phorton1/Arduino-TE3/docs/_old/readme_old.md

# TE3 - teensyExpression3

This is the third, and hopefully last, major iteration of
the teensyExpression/vGuitar rig design and implementation.

Please see the
[vGuitar System](https://github.com/phorton1/phorton1/blob/master/vGuitar/vGuitar.md)
for information regardind the system as a whole.

From a **software perspective**, this repo contains the source code
for the portion of the system that runs on a *teensy4.1* which handles the
"foot pedal" part of the system, as well as acting as the central coordinator
of communications over serial ports and much of the USB Midi to the iPad.

It inherits the functionality of the previous TeensyExpression pedal AND
the previous teensyPiLooper programs, as well as adding new functionality.

- is a USB Midi Device (Midi Controller)
- handles the buttons, rotaries, and expression pedals
- has a TFT display device (possibly with touch capabilities)
- has an SD card for storing SongMachine (and possibly other) files
- is intimately aware of the Midi Protocols used by the FTP
- *may* include a USB Host Port for the FTP (Fishman Triple Play)
- *may* provide *FTP Spoofing* capabilities

It acts as the central communication hub for handling and routing
Serial Midi, Serial Debugging, and Serial File Management to the
other parts of the system.

- communicates via Serial Midi with the TE3_Audio device
- communicates via Serial Midi with the rPi Looper program
- communicates via USB Midi with the iPad
- communicates via USB or dedicated Serial Port with the console.pm program

From an **electronics perspective**, this repo contains **all** of the
kicad schematics and PCB layouts for the entire system.

From a **3D printing perspective**, this repo contains **all** of the
Fusion 360 designs, STL files, Prusa and Lightburn Projects, and gcode
files for building the foot pedal.

## Implementation Notes

### USBC Hub

I will be using the store bought powered USBC hub, along with two
USBC female breakout boards with their resistors removed.

This gives me a high quality hub that can (a) fit in the box, (b) have
a decent pair of rear-facing USBC female plugs, and (c) work in
any cable orientation.

The tricky connections on the hub (photos needed) are:

- **USBC power input** - created a USBC stub cable with a 6 pin JST
  connector that matches the pins on the USBC breakout boards
  - VBUS == 22ga red
  - GND  == 22ga black
  - CC1  == 24ga blue
  - CC2  == 24ga yellow
- **USBC power and data to iPad** - soldered wires from the
  bottom of the USB hub to a 5 pin JST connnector that matches
  the pins on the USBC breakout board:
  - D-   == 22ga green
  - D+   == 22ga yellow
  - GND  == 24ga black
  - CC1  == 22ga white
  - VBUS == 24ga red
  - connect CC2 to CC1

I am only using higher quality, fine strand, tinned, silicon wires
in the TE3 project.

On the iPad output side, I found that if I merely connect CC1 to
CC2, the USBC cable works in either orientation!

The iPad charges at 15V upto about 2.5A, or 26W or so.
The hub does not seem to get unduly hot.

I have verified that I can take 5V to power the rPi from the USBC
hub by drilling some holes and mounting a 2 pin JST connector or
cable that terminates in a 2 pin JST connector.

I merely have to solve the issue of how I connect the USB2 ports
for TE3, TE3_audio, and the FTP.  I am still trying to figure out
how to retrofit a 4 pin JST connector of some kind for that, but
may have to solder cables to the board cuz of the non-standard
pin layouts.

## Please also see

[**TE3_audio**](https://github.com/phorton1/Arduino-TE3_audio)
The **USB Audio** device that also communicates with the rPi Looper
via I2s.

[**TE3_common**](https://github.com/phorton1/Arduino-libraries/TE3_commo)
Functionality and definitions common to the **TE3** and **TE3_audio** programs.

The [**circle-Looper**](https://github.com/phorton1/circle-prh-apps-Looper)
repo contains the source code for the **rPi Looper** application that runs
on a Raspberry Pi that is interfaced to this device.
