phorton1/Arduino-TE3/docs/images/3dp-back_fastener.jpg

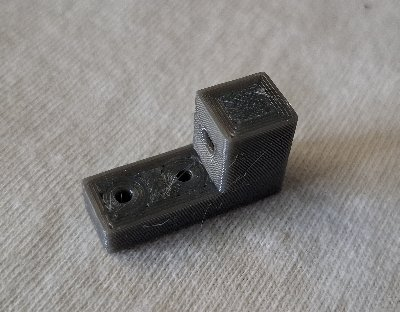
docs/images/3dp-back_fastener.jpg
