phorton1/Arduino-TE3/docs/images/3dp-bezel.jpg

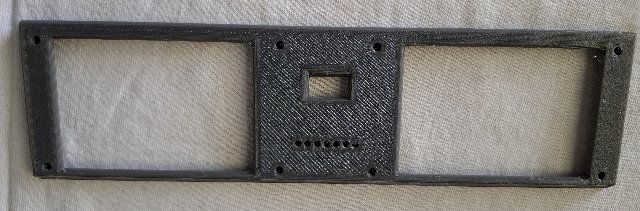
docs/images/3dp-bezel.jpg
