phorton1/Arduino-TE3/docs/images/3dp-button.jpg

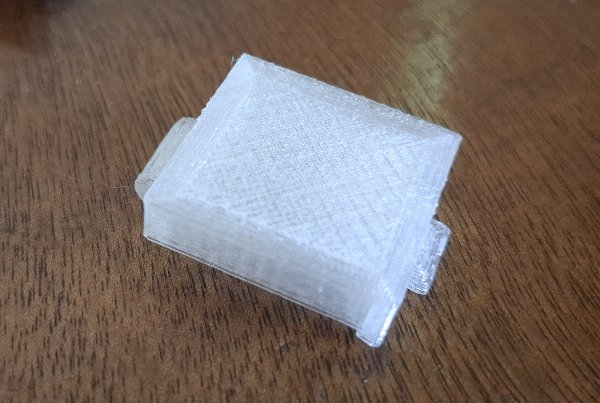
docs/images/3dp-button.jpg
