phorton1/Arduino-TE3/docs/images/3dp-button_bases.jpg

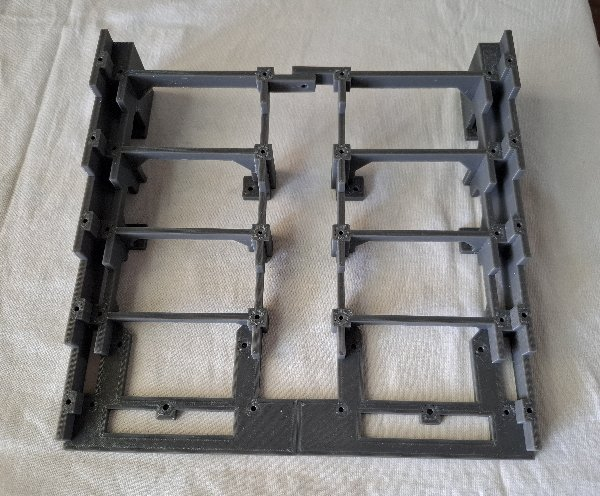
docs/images/3dp-button_bases.jpg
