phorton1/Arduino-TE3/docs/images/3dp-row_base.jpg

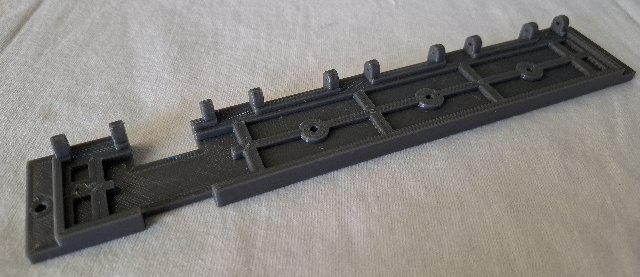
docs/images/3dp-row_base.jpg
