phorton1/Arduino-TE3/docs/images/3dp-slider_bottom.jpg

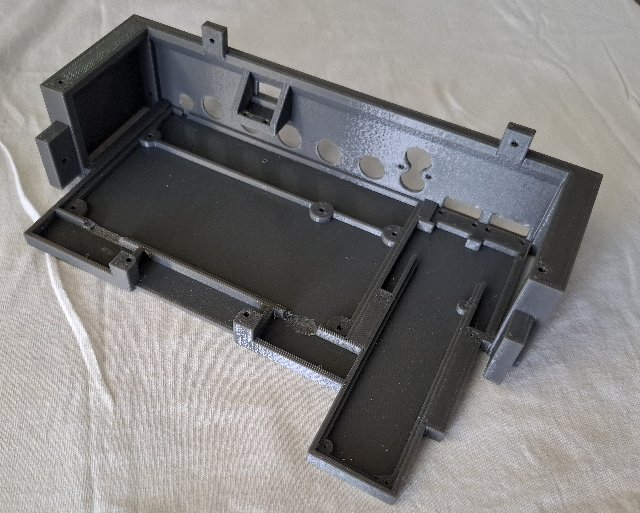
docs/images/3dp-slider_bottom.jpg
