phorton1/Arduino-TE3/docs/images/3dp-slider_top.jpg

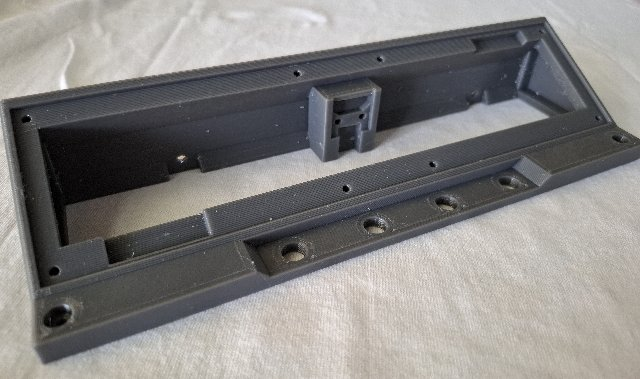
docs/images/3dp-slider_top.jpg
