phorton1/Arduino-TE3/docs/images/3dp-wood_base1_big.jpg

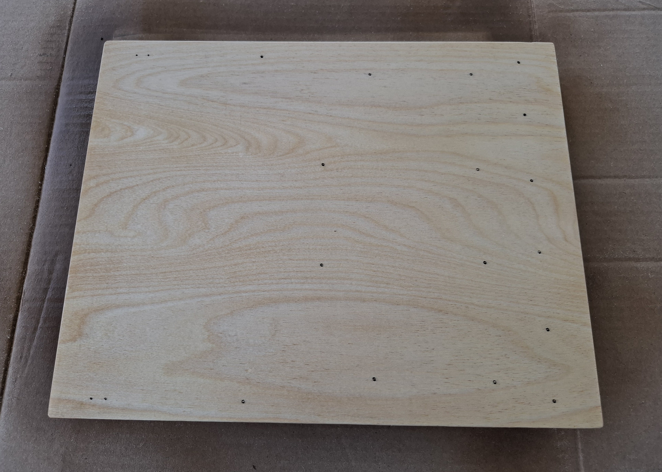
docs/images/3dp-wood_base1_big.jpg
