phorton1/Arduino-TE3/docs/images/home-overview1.jpg

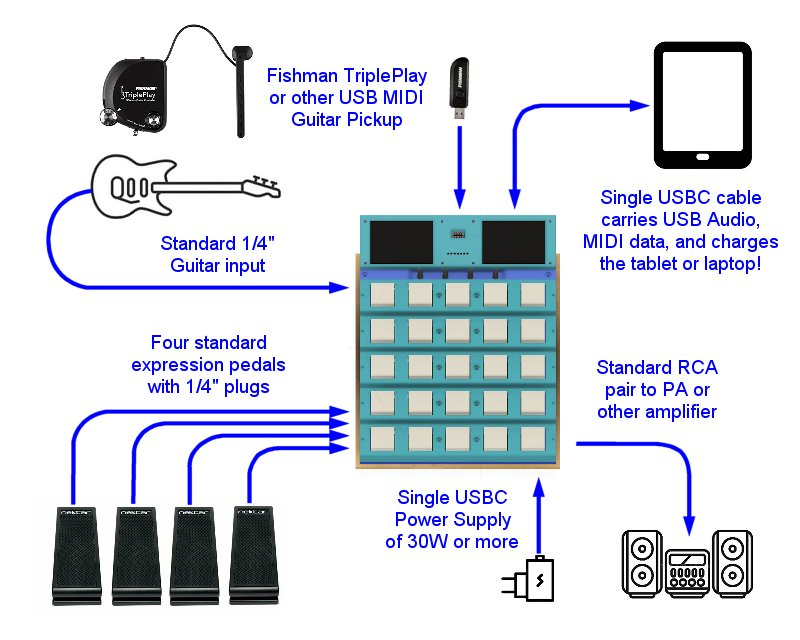
docs/images/home-overview1.jpg
