phorton1/Arduino-TE3/docs/images/pcbs-lcd_connector_front.jpg

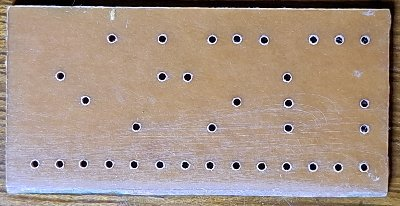
docs/images/pcbs-lcd_connector_front.jpg
