phorton1/Arduino-TE3/docs/images/pcbs-led_board_back_big.jpg

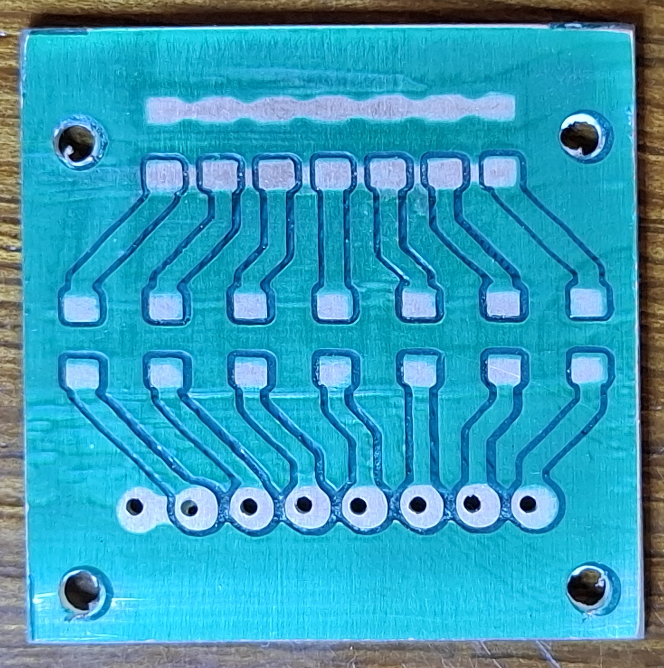
docs/images/pcbs-led_board_back_big.jpg
