phorton1/Arduino-TE3/docs/images/pcbs-led_board_front.jpg

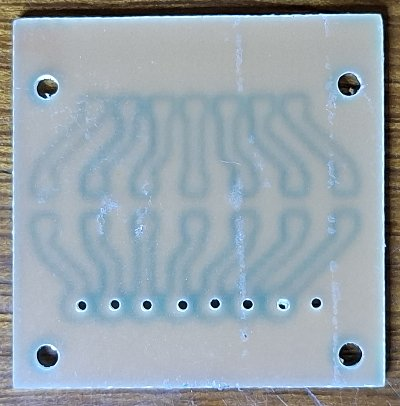
docs/images/pcbs-led_board_front.jpg
