phorton1/Arduino-TE3/docs/images/3dp-all_parts.jpg

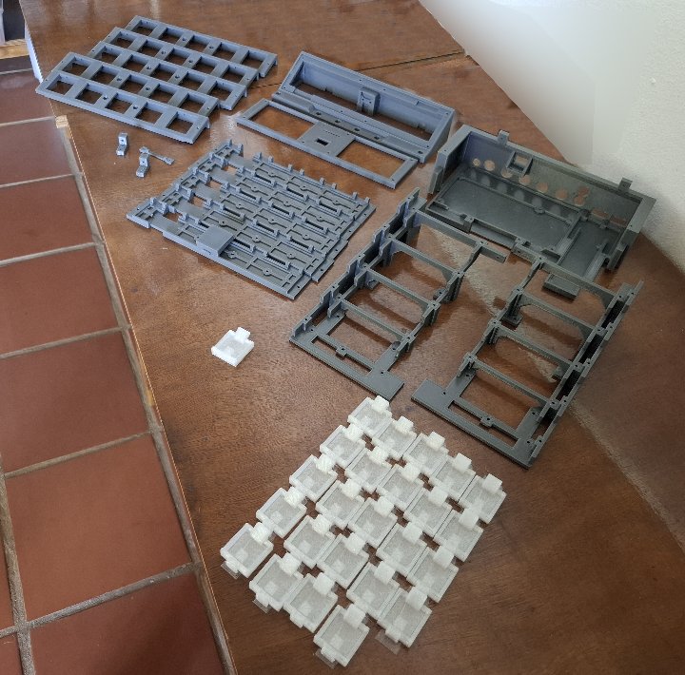
docs/images/3dp-all_parts.jpg
