phorton1/Arduino-TE3/docs/fusion/button_cap.stl

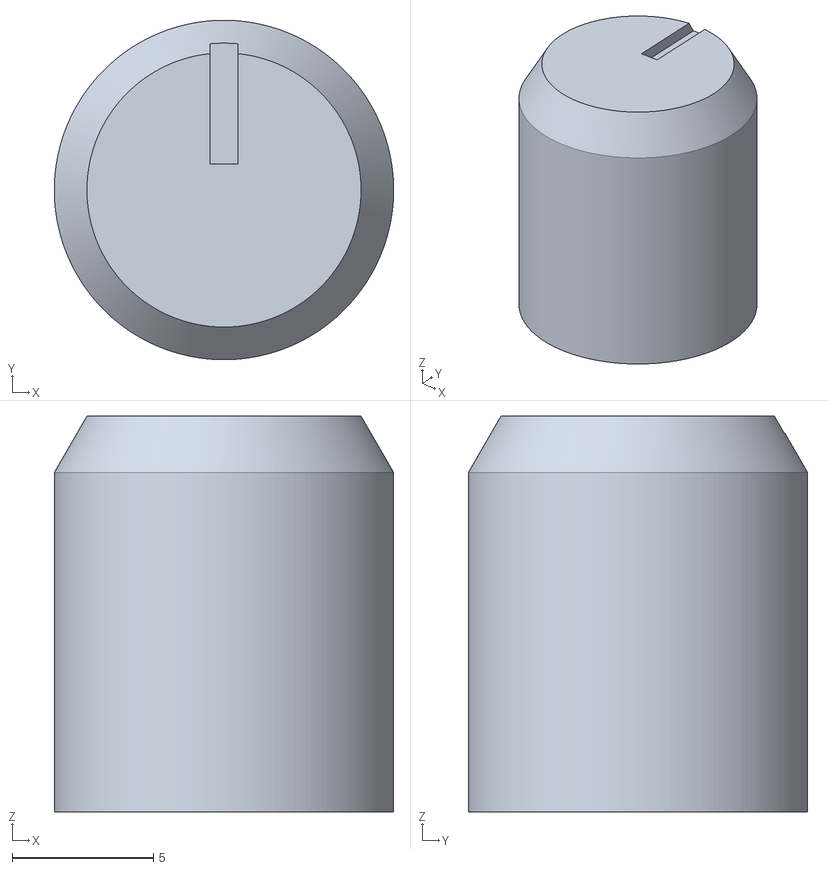
[picture p32: CAD file, 2025-03-22]
docs/fusion/button_cap.stl
12.0 x 12.0 x 14.0
