phorton1/Arduino-TE3/docs/kicad/lcd_connector/lcd_connector.step

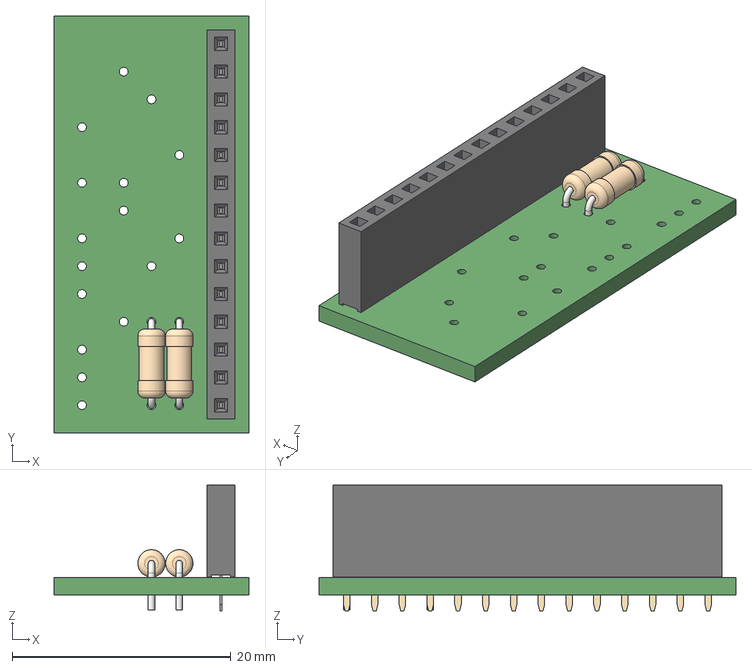
[picture p33: CAD file, 2025-02-02]
docs/kicad/lcd_connector/lcd_connector.step
17.8 x 38.1 x 11.5 mm
