phorton1/Arduino-TE3/docs/kicad/led_board/led_board.step

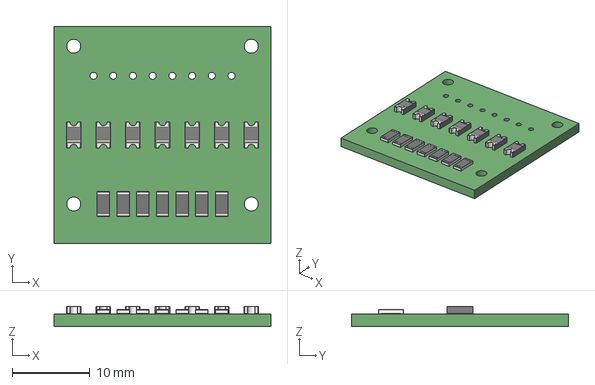
[picture p34: CAD file, 2025-02-14]
docs/kicad/led_board/led_board.step
27.9 x 27.9 x 2.61 mm
