phorton1/Arduino-TE3/docs/kicad/rotary_board/rotary_board.step

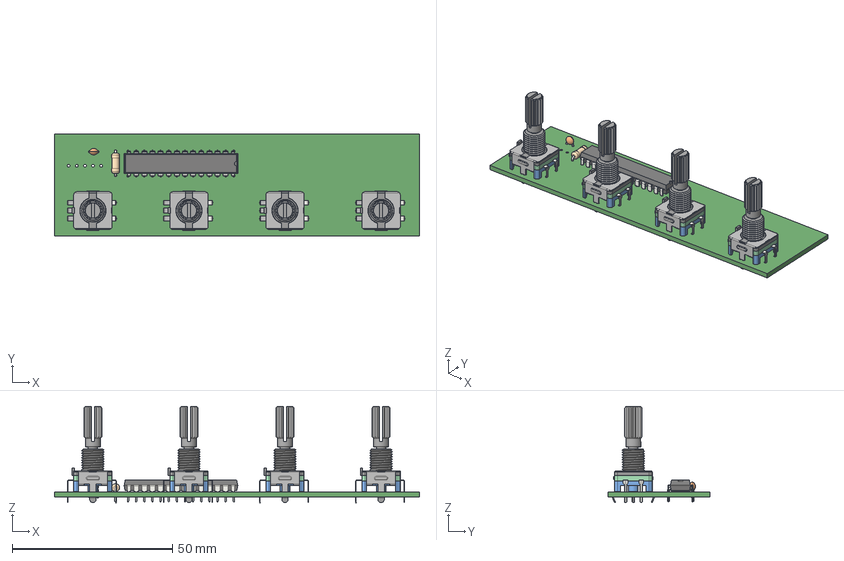
[picture p35: CAD file, 2025-02-27]
docs/kicad/rotary_board/rotary_board.step
114.0 x 32.0 x 30.1 mm
