phorton1/Arduino-TE3/docs/kicad/row_board/row_board.step

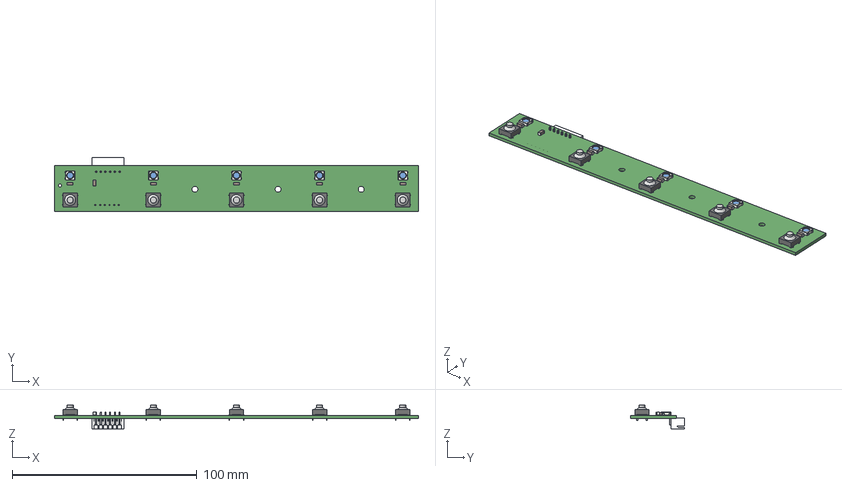
[picture p36: CAD file, 2025-02-11]
docs/kicad/row_board/row_board.step
197.0 x 29.2 x 12.9 mm
