phorton1/Arduino-TE3/docs/kicad/usba_connector/usba_connector.step

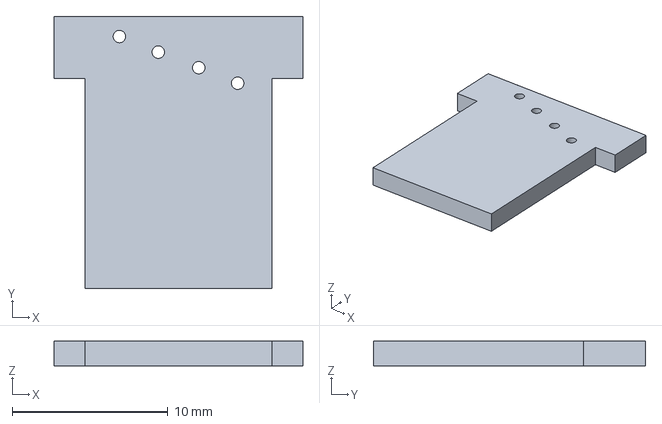
[picture p37: CAD file, 2025-03-05]
docs/kicad/usba_connector/usba_connector.step
16.0 x 17.5 x 1.60 mm
