phorton1/Arduino-TE3/docs/lightburn/laser_cut_base.dxf

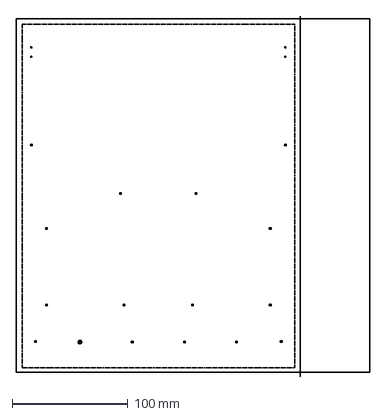
[picture p38: CAD file, 2025-03-06]
docs/lightburn/laser_cut_base.dxf
304.8 x 311.0 mm
