phorton1/Arduino-TE3/docs/prusa/button_cap_x_4.3mf

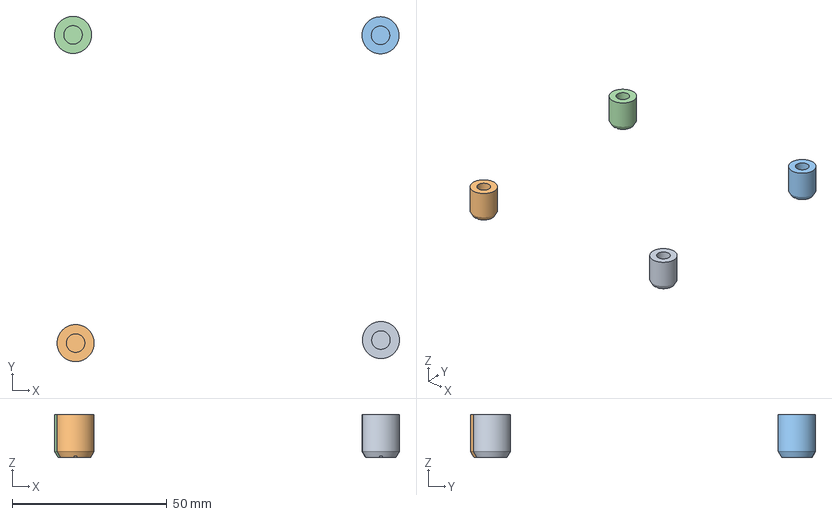
[picture p39: CAD file, 2025-03-22]
docs/prusa/button_cap_x_4.3mf
111.5 x 111.6 x 14.0 mm
button_cap.stl x 4
