phorton1/Arduino-TE3/docs/fusion/slider_bottom.stl

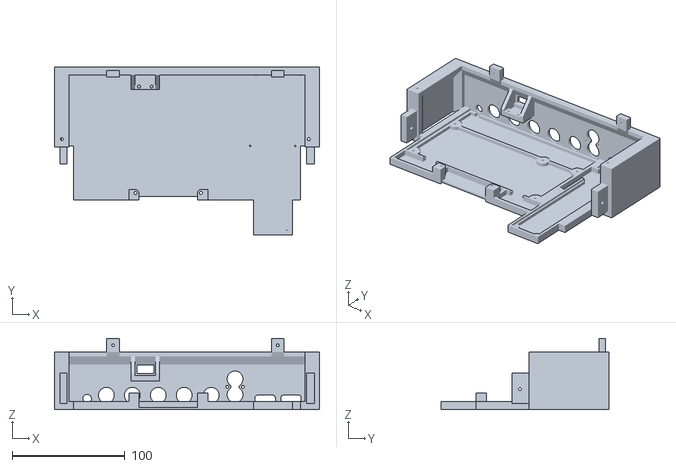
[picture p40: CAD file, 2025-03-07]
docs/fusion/slider_bottom.stl
235.0 x 149.0 x 63.0
