phorton1/Arduino-TE3/docs/fusion/back_fastener.stl

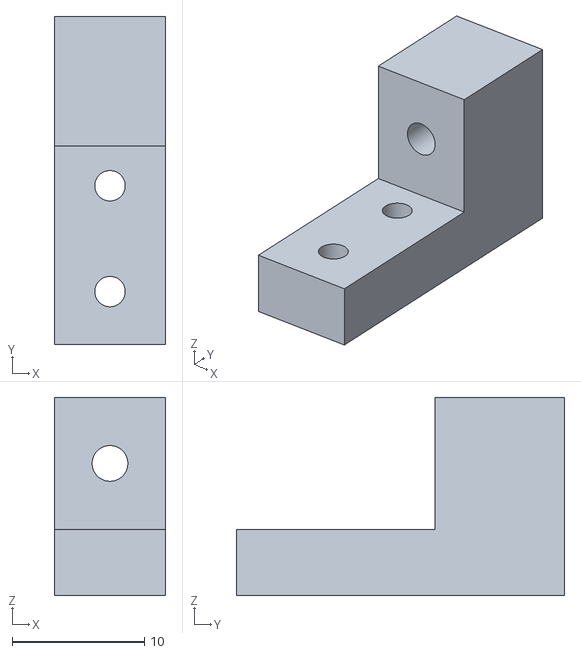
[picture p41: CAD file, 2025-03-07]
docs/fusion/back_fastener.stl
8.40 x 24.8 x 15.0
