phorton1/Arduino-TE3/docs/prusa/back_fasteners.3mf

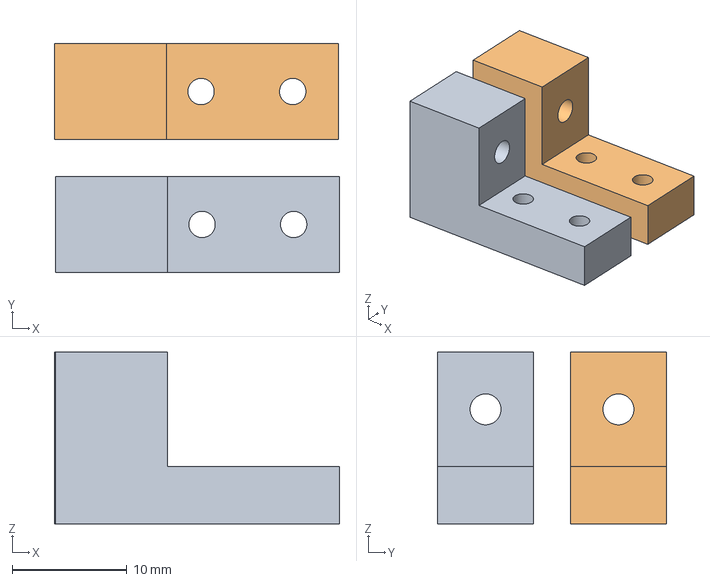
[picture p42: CAD file, 2025-03-07]
docs/prusa/back_fasteners.3mf
24.9 x 20.0 x 15.0 mm
back_fastener.stl x 2
