phorton1/Arduino-TE3/docs/fusion/usb_connector_bottom.stl

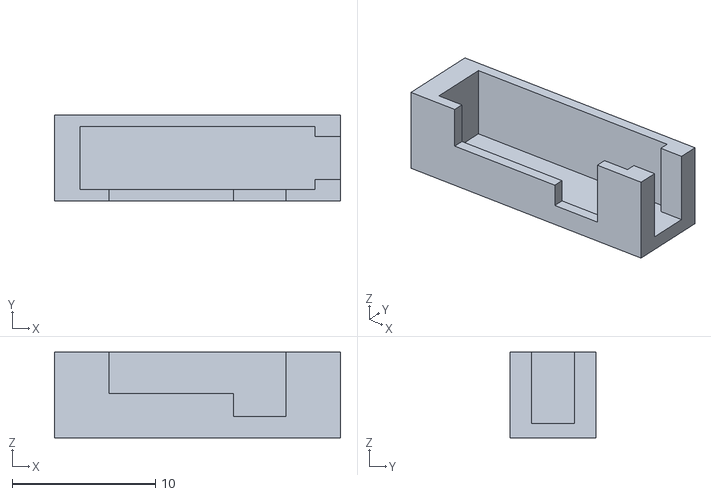
[picture p43: CAD file, 2025-03-05]
docs/fusion/usb_connector_bottom.stl
20.0 x 6.00 x 6.00
