phorton1/Arduino-TE3/docs/prusa/bezel.3mf

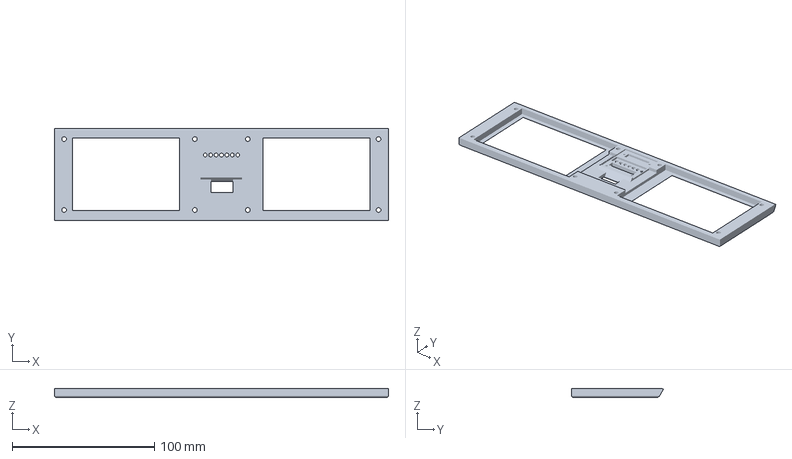
[picture p44: CAD file, 2025-03-05]
docs/prusa/bezel.3mf
235.0 x 64.7 x 6.50 mm
