phorton1/Arduino-TE3/docs/fusion/usb_connector_top.stl

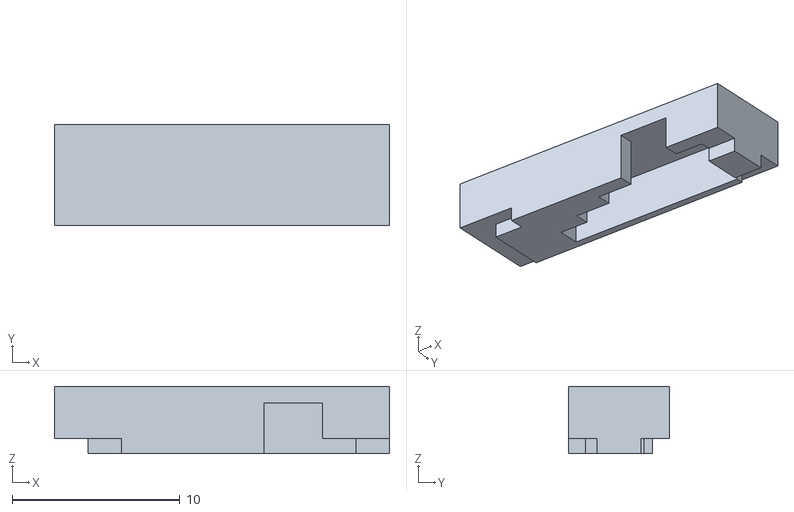
[picture p45: CAD file, 2025-03-05]
docs/fusion/usb_connector_top.stl
20.0 x 6.00 x 4.00
