phorton1/Arduino-TE3/docs/prusa/row_button_x25_PLA.3mf

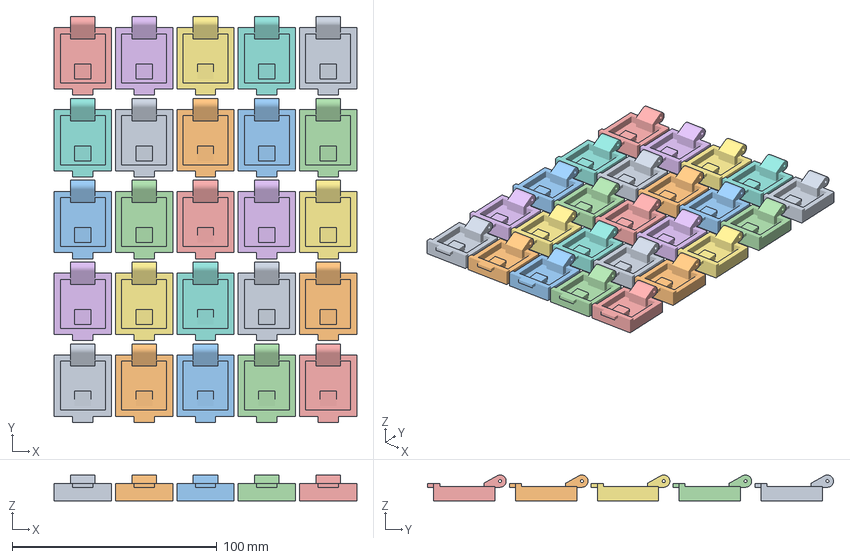
[picture p46: CAD file, 2025-03-05]
docs/prusa/row_button_x25_PLA.3mf
148.0 x 198.5 x 12.7 mm
row_button.stl x 25
