phorton1/Arduino-TE3/docs/fusion/slider_top.stl

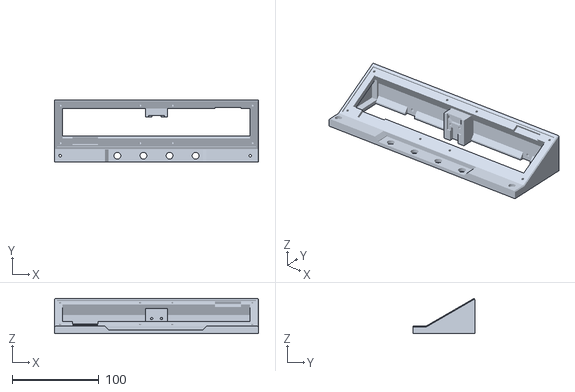
[picture p47: CAD file, 2025-02-27]
docs/fusion/slider_top.stl
235.0 x 71.0 x 40.7
