phorton1/Arduino-TE3/docs/prusa/usb_connector_x3.3mf

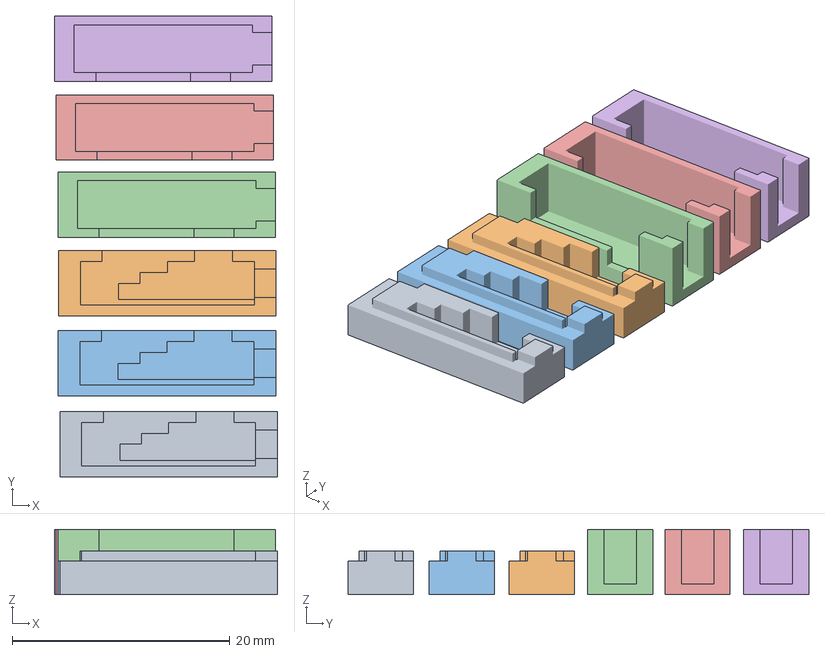
[picture p48: CAD file, 2025-03-05]
docs/prusa/usb_connector_x3.3mf
20.5 x 42.4 x 6.00 mm
usb_connector_top.stl x 3
usb_connector_bottom.stl x 3
