phorton1/Arduino-TE3/docs/fusion/bezel.stl

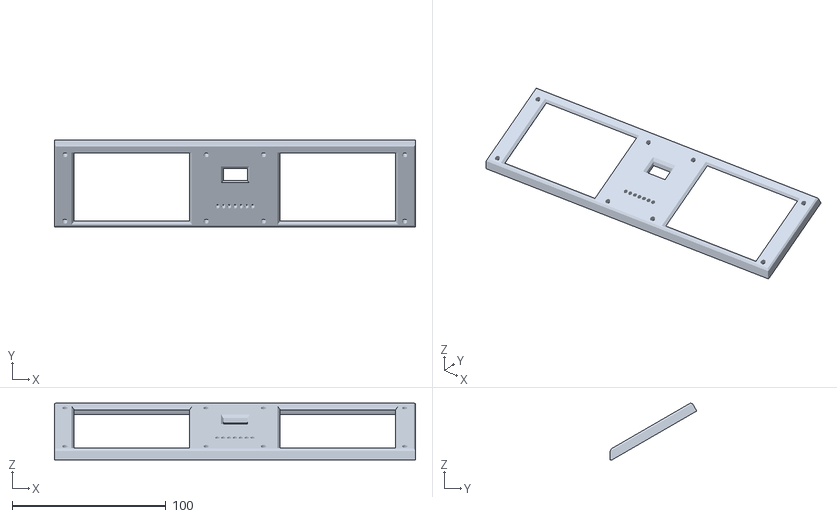
[picture p49: CAD file, 2025-02-27]
docs/fusion/bezel.stl
235.0 x 56.3 x 37.0
