phorton1/Arduino-TE3/docs/fusion/hub_holder.stl

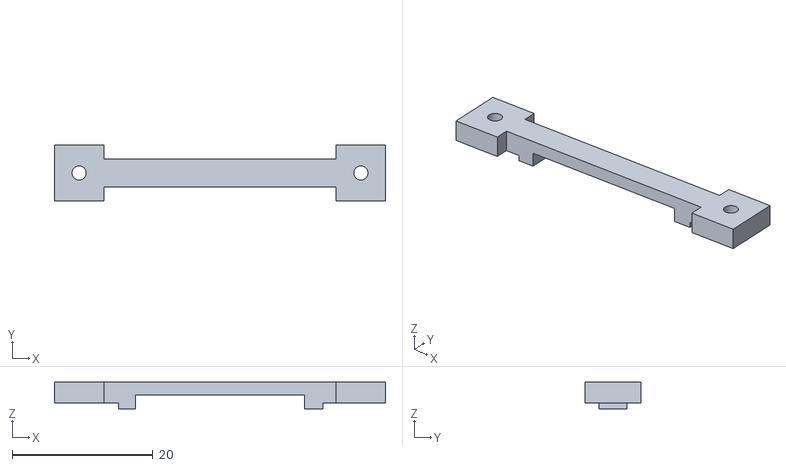
[picture p50: CAD file, 2025-02-27]
docs/fusion/hub_holder.stl
47.0 x 8.00 x 3.80
