phorton1/Arduino-TE3/docs/prusa/button_base_right.3mf

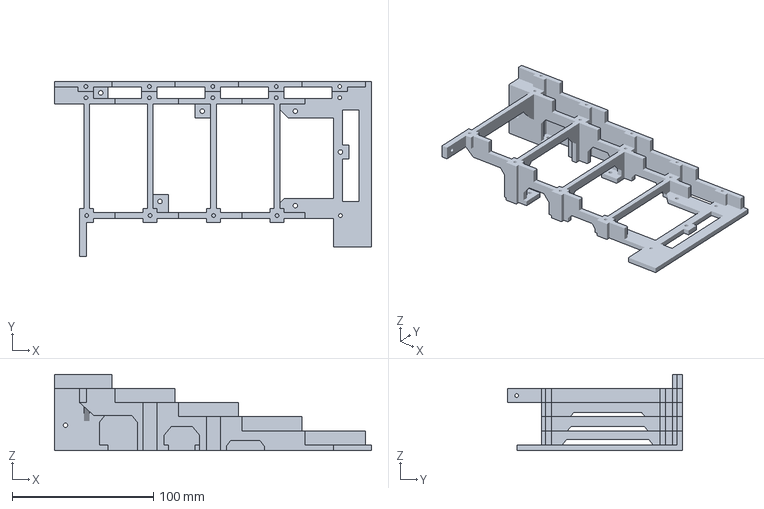
[picture p51: CAD file, 2025-02-25]
docs/prusa/button_base_right.3mf
224.8 x 124.0 x 54.0 mm
