phorton1/Arduino-TE3/docs/fusion/row_base.stl

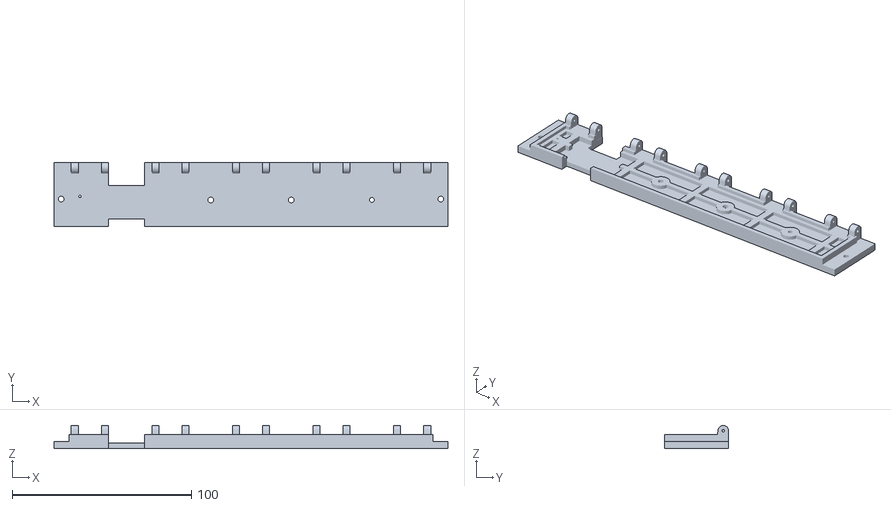
[picture p52: CAD file, 2025-02-25]
docs/fusion/row_base.stl
220.0 x 35.9 x 12.9
