phorton1/Arduino-TE3/docs/prusa/row_base_x4.3mf

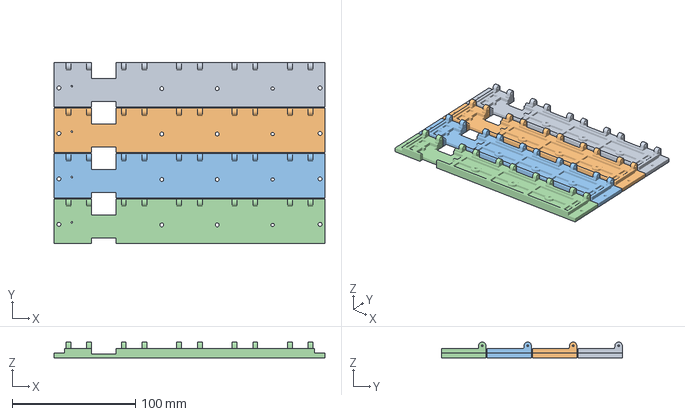
[picture p53: CAD file, 2025-02-25]
docs/prusa/row_base_x4.3mf
220.0 x 146.6 x 12.9 mm
row_base.stl x 4
