phorton1/Arduino-TE3/docs/fusion/row_cover.stl

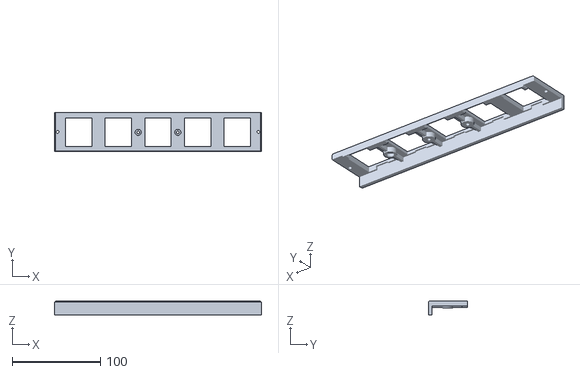
[picture p54: CAD file, 2025-02-25]
docs/fusion/row_cover.stl
235.0 x 44.8 x 15.6
