phorton1/Arduino-TE3/docs/prusa/row_test.3mf

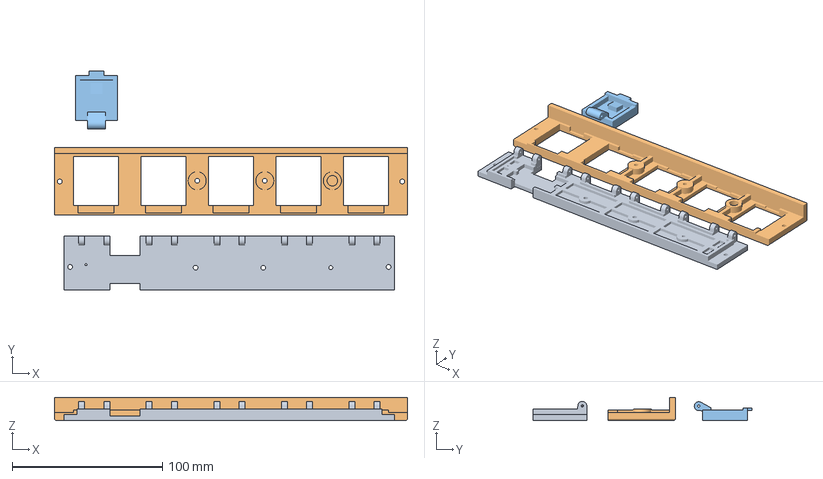
[picture p55: CAD file, 2025-02-25]
docs/prusa/row_test.3mf
235.0 x 145.9 x 15.6 mm
row_base.stl
row_cover.stl
row_button.stl
