phorton1/Arduino-TE3/docs/prusa/row_cover_x4.3mf

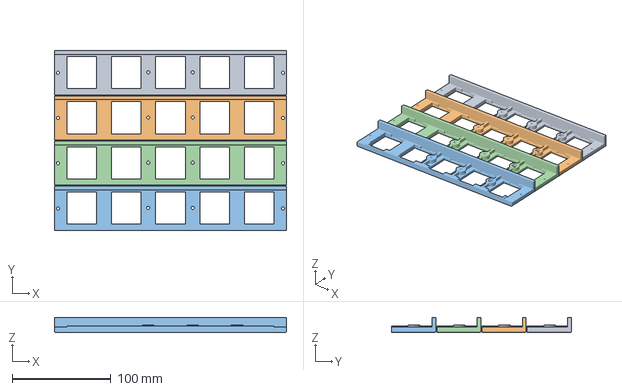
[picture p56: CAD file, 2025-02-25]
docs/prusa/row_cover_x4.3mf
235.0 x 182.2 x 15.6 mm
row_cover.stl x 4
