phorton1/Arduino-TE3/docs/fusion/row_button.stl

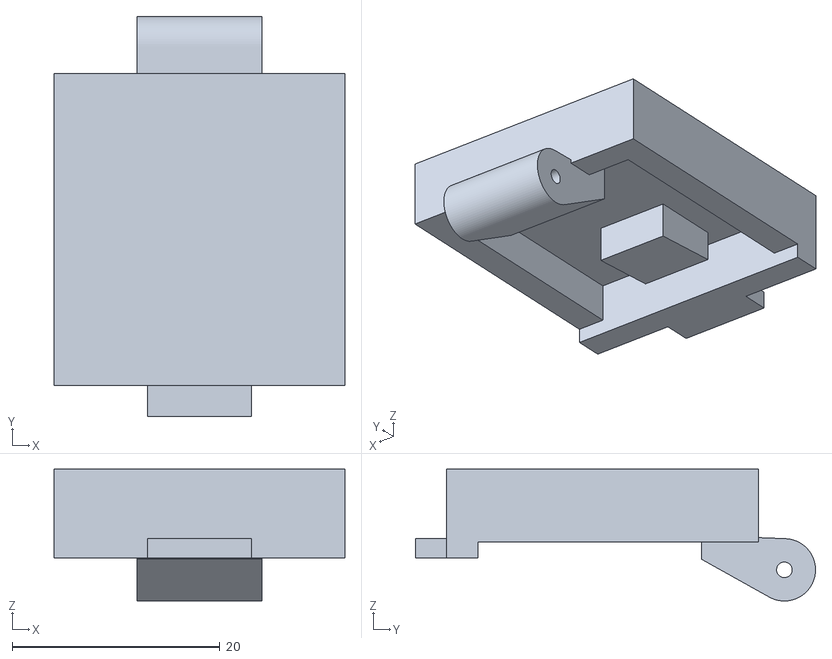
[picture p57: CAD file, 2025-02-25]
docs/fusion/row_button.stl
28.0 x 38.5 x 12.7
