phorton1/Arduino-TE3/(list of files, cad)

Other CAD files:
docs/prusa/slider_bottom.3mf
docs/prusa/slider_top.3mf
docs/fusion/button_base_left.stl
docs/prusa/button_base_left.3mf
docs/fusion/button_base_right.stl
docs/fusion/usba_connector_plastic.f3d
docs/kicad/led_board/plot/led_board-F_Paste.dxf
docs/kicad/row_board/plot/row_board-F_Paste.dxf
