phorton1/Arduino-TE3/docs/fusion/build_anim2/Image01.jpg

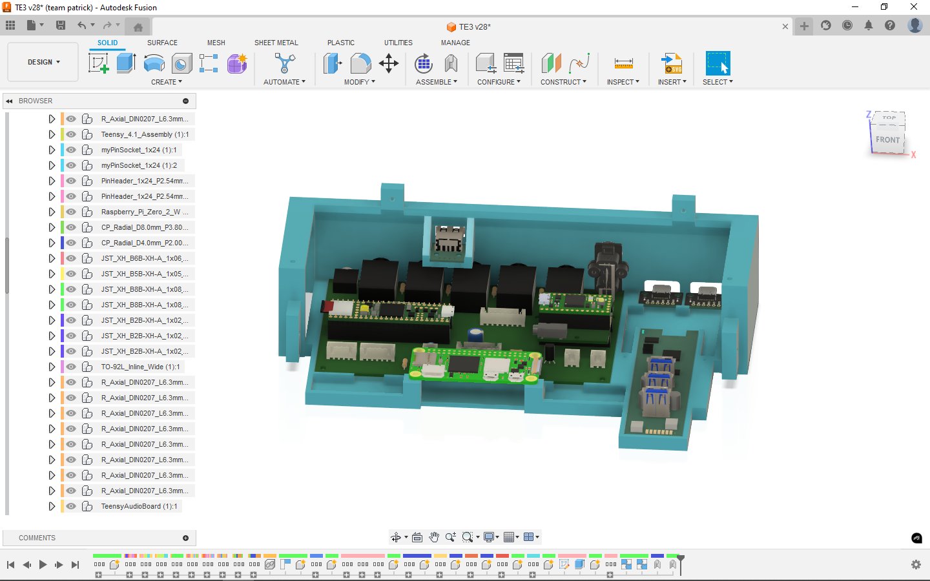
docs/fusion/build_anim2/Image01.jpg
