phorton1/Arduino-TE3/docs/fusion/build_anim2/Image02.jpg

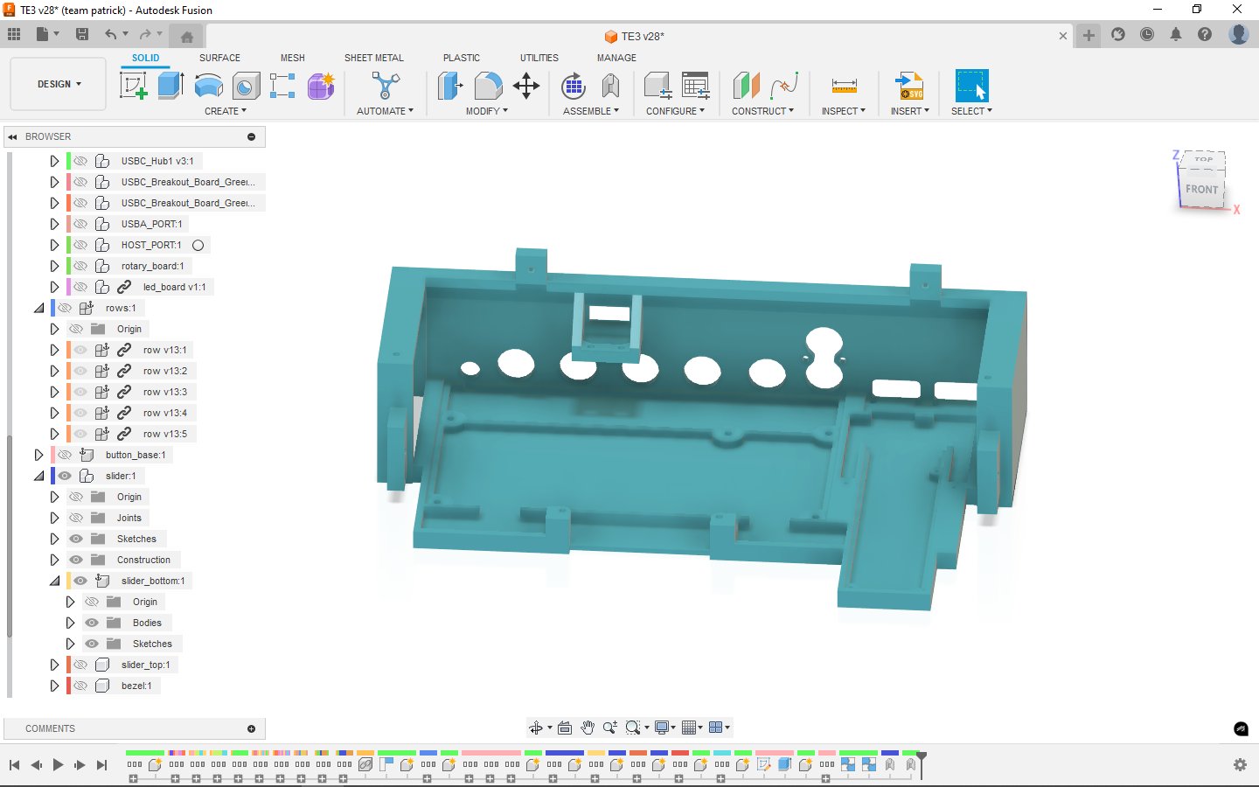
docs/fusion/build_anim2/Image02.jpg
