phorton1/Arduino-TE3/docs/fusion/build_anim3/Image00.jpg

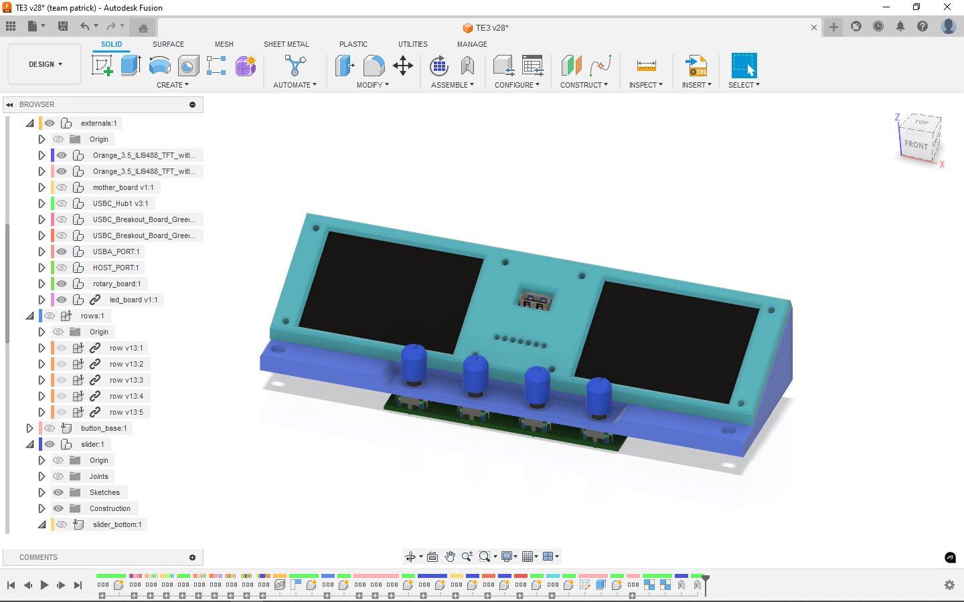
docs/fusion/build_anim3/Image00.jpg
