phorton1/Arduino-TE3/docs/fusion/build_anim3/Image03.jpg

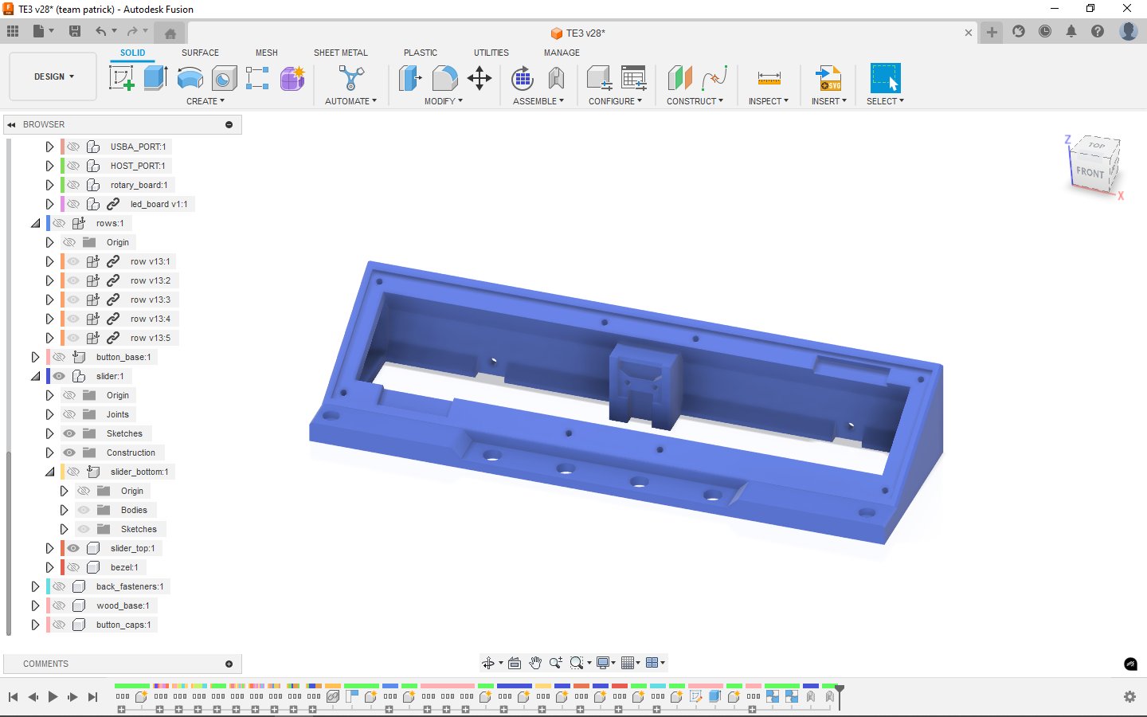
docs/fusion/build_anim3/Image03.jpg
