phorton1/Arduino-TE3/docs/fusion/build_anim4/Image1.jpg

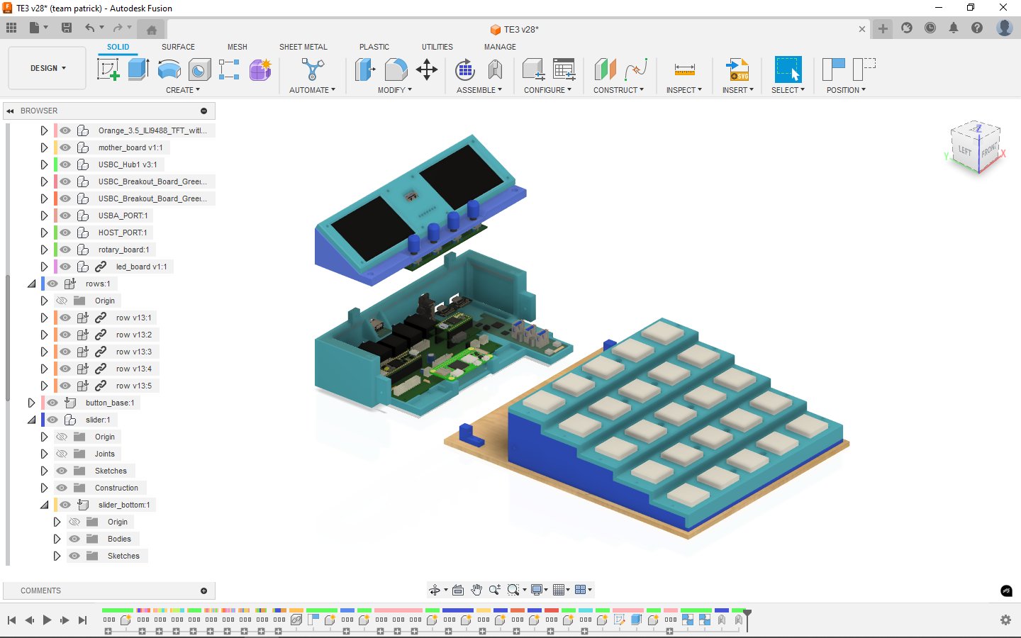
docs/fusion/build_anim4/Image1.jpg
