phorton1/Arduino-TE3/docs/images/build-anim1.gif

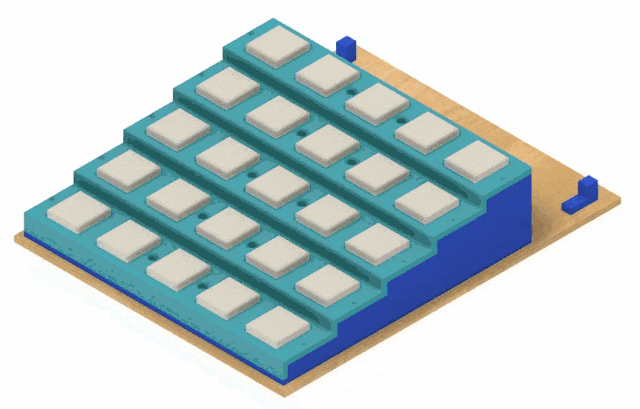
docs/images/build-anim1.gif
