phorton1/Arduino-TE3/docs/images/build-anim2.gif

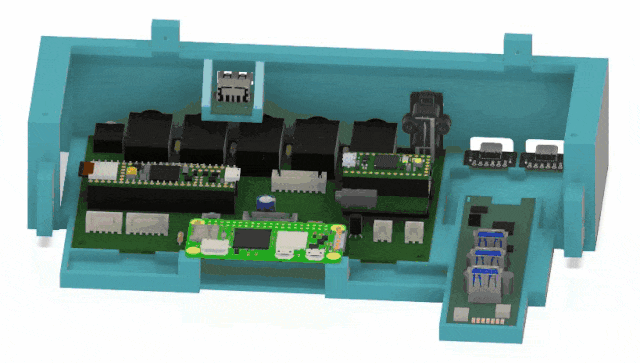
docs/images/build-anim2.gif
