phorton1/Arduino-TE3/docs/images/build-anim3.gif

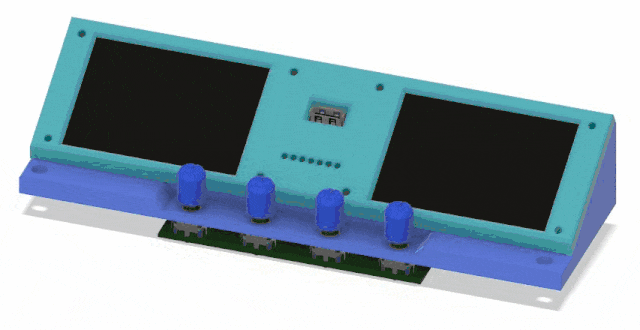
docs/images/build-anim3.gif
