phorton1/Arduino-TE3/docs/images/build-anim4.gif

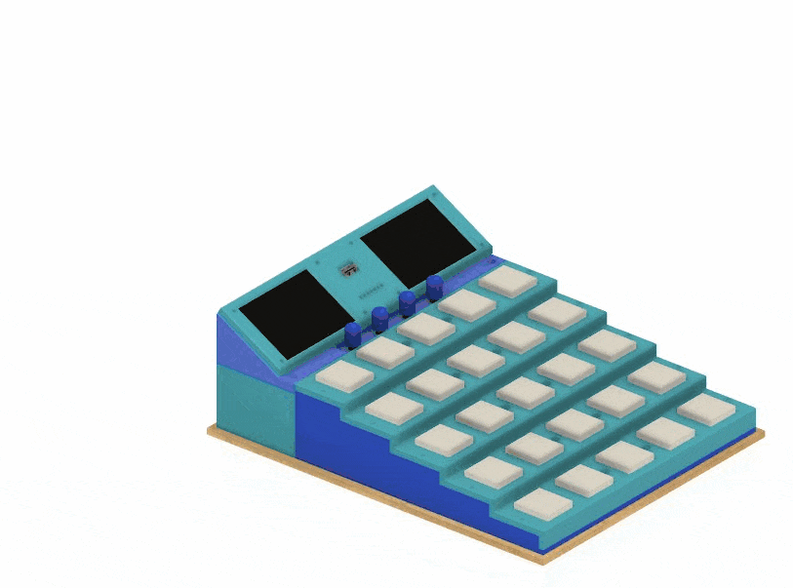
docs/images/build-anim4.gif
