phorton1/Arduino-TE3/docs/images/solder-row_board_cable.jpg

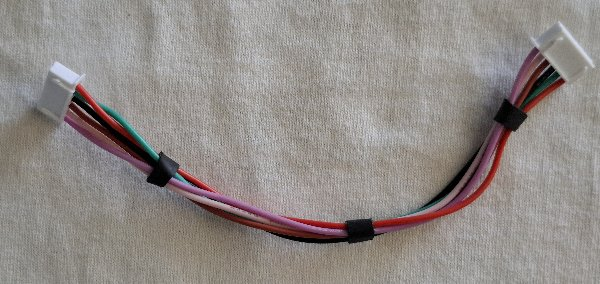
docs/images/solder-row_board_cable.jpg
