phorton1/Arduino-TE3/docs/images/solder-test_setup.jpg

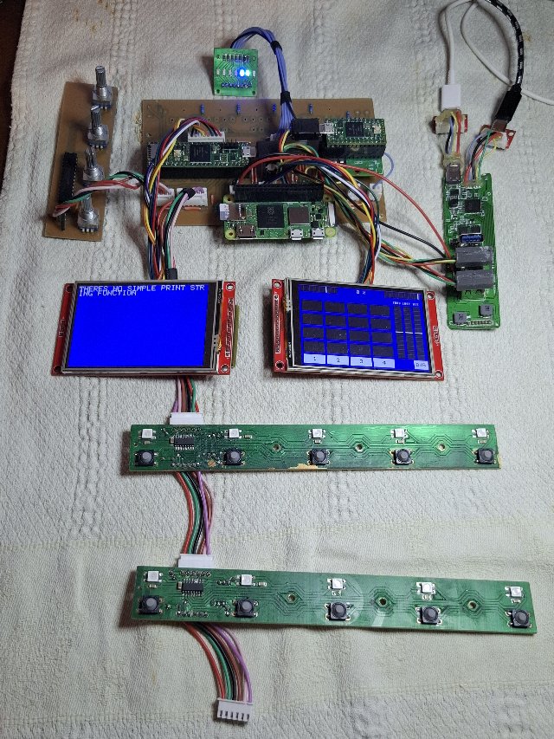
docs/images/solder-test_setup.jpg
