phorton1/Arduino-TE3/docs/kicad/mother_board/mother_board.kicad_pcb

## KiCad design docs/kicad/mother_board/mother_board.kicad_pcb (2025-03-18)

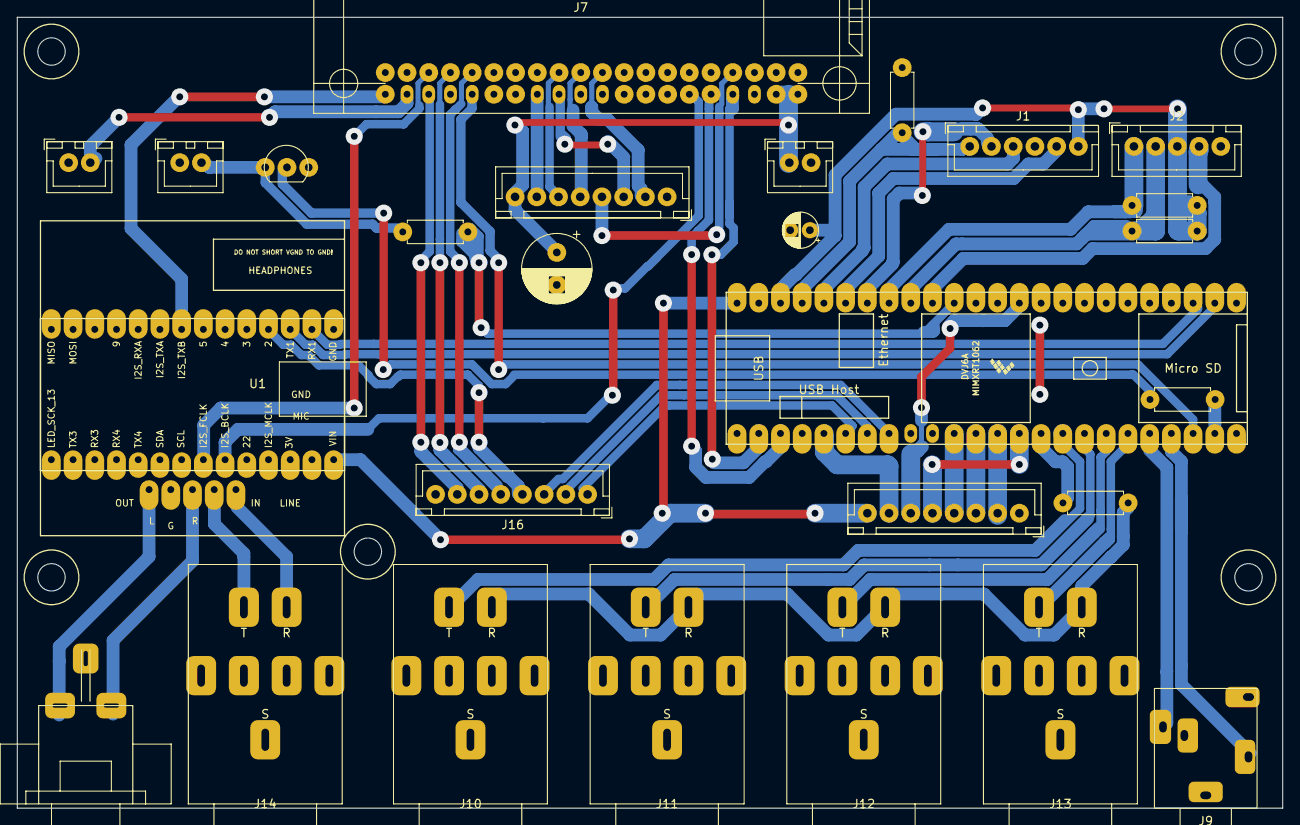
[picture p93: board mother_board.kicad_pcb from above]

Board: 2 copper layers, 148.0 x 92.5 mm, 27 parts (0 on the bottom side), 54 nets.

Parts:
C1: 100uf; CP_my100uf
C2: 47uf; CP_my10uf
J1: ROW_BOARDS; myJSTx06
J2: ROTARIES; myJSTx05
J3: TE_DISPLAY; myJSTx08
J4: RPI_DISPLAY; myJSTx08
J5: rPi_5V; myJSTx02
J6: RPI_RUN; myJSTx02
J7: rpi_connector; rpi_zero_2w_for_TE3
J8: I2S_TXB; myJSTx02
J9: EigthInchJack1
J10: PEDAL1; QuarterInchJack1
J11: PEDAL2; QuarterInchJack1
J12: PEDAL3; QuarterInchJack1
J13: PEDAL4; QuarterInchJack1
J14: GUITAR_IN; QuarterInchJack1
J15: LINE_OUT; RCA2_PCB_milled
J16: LEDS; myJSTx08
Q1: BC547; myTransistor
R1, R2, R4: 1K; myResistor
R3, R5: 220; myResistor
R11: 10K; myResistor
U1: teensyAudioRevD_WithAudio; audioShieldRevD_audioPinsStack
U2: myTeensy4.1; teensy41

Connections:
+5V: J3.8, U1.28, U2.48
BTN_CLK: J1.5, U2.43
BTN_DIN: J1.3, U2.44
BTN_SENSE: J1.1, R11.1, U2.45
GND: C1.2, C2.2, J1.4, J2.5, J3.1, J4.1, J5.2, J6.1, J7.6, J7.9, J7.14, J7.20, J7.25, J7.30, J7.34, J7.39, J8.1, J9.S, J10.S, J11.S, J12.S, J13.S, J14.S, J15.G, J16.8, Q1.3, R11.2, U1.1, U1.27, U1.32, U2.1, U2.34, U2.47
I2S_BCLK: J7.12, U1.23
I2S_FCLK: J7.35, U1.22
I2S_RXB: J7.40, U1.8
I2S_TXB: J7.38, J8.2
LED_AUDIO_BUSY: J16.4, U1.4
LED_DIN: J1.2, U2.42
LED_RPI_BUSY: J7.31, J16.5
LED_RPI_I2S_RX: J7.33, J16.6
LED_RPI_I2S_TX: J7.36, J16.7
LED_RPI_READY: J16.3, U2.8
LED_RPI_RUN: J16.2, U2.7
LED_T3_BUSY: J16.1, U2.6
LINE_IN_L: J14.R, U1.29
LINE_IN_R: J14.T, U1.30
LINE_OUT_L: J15.L, U1.33
LINE_OUT_R: J15.R, U1.31
unnamed: J10.R, J11.R, J12.R, J13.R, R5.2
unnamed: Q1.2, R4.2
PEDAL1: J10.T, U2.16
PEDAL2: J11.T, U2.17
PEDAL3: J12.T, U2.18
PEDAL4: J13.T, U2.19
PI_REBOOT: R4.1, U2.23
ROT_INT: J2.4, U2.39
RPI_5V: C1.1, J4.8, J5.1, J7.2, J7.4
RPI_LCD_CS: J4.3, J7.24
RPI_LCD_DC: J4.4, J7.7
RPI_MISO: J4.5, J7.21
RPI_MOSI: J4.2, J7.19
RPI_READY: J7.32, U2.22
RPI_RUN: J6.2, Q1.1, R3.2
RPI_SCLK: J4.6, J7.23
RPI_T_CS: J4.7, J7.26
SENS_PI_RUN: R3.1, U2.38
T41_3V3: C2.1, J1.6, J2.3, R1.1, R2.1, R5.1, U2.15, U2.46
T41_LCD_CS: J3.3, U2.12
T41_LCD_DC: J3.4, U2.11
T41_MISO: J3.5, U2.14
T41_MOSI: J3.2, U2.13
T41_RX1: J7.8, U2.2
T41_RX7: J9.T, U2.21
T41_RX8: U1.3, U2.26
T41_SCL: J2.1, R1.2, U2.41
T41_SCLK: J3.6, U2.35
T41_SDA: J2.2, R2.2, U2.40
T41_TX1: J7.10, U2.3
T41_TX7: J9.R, U2.20
T41_TX8: U1.2, U2.27
T41_T_CS: J3.7, U2.5
