phorton1/Arduino-TE3/docs/kicad/lcd_connector/lcd_connector.kicad_pcb

## KiCad design docs/kicad/lcd_connector/lcd_connector.kicad_pcb (2025-03-05)

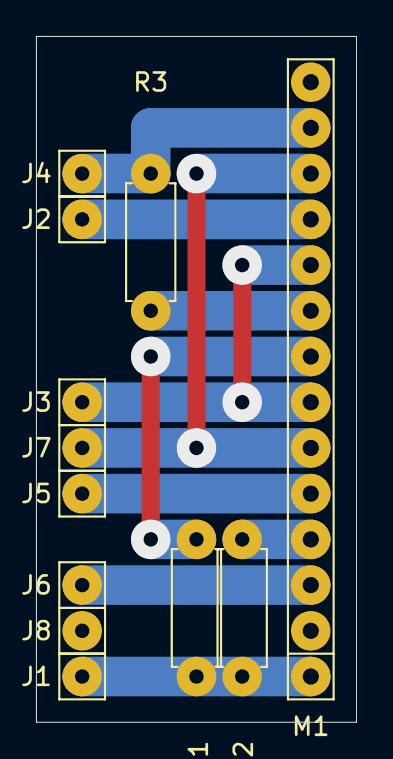
[picture p94: board lcd_connector.kicad_pcb from above]

Board: 2 copper layers, 17.8 x 38.1 mm, 12 parts (0 on the bottom side), 11 nets.

Parts:
J1: 5V; my1pin
J2: T_CS; my1pin
J3: CLK; my1pin
J4: MISO; my1pin
J5: DC; my1pin
J6: CS; my1pin
J7: MOSI; my1pin
J8: GND; my1pin
M1: TFT_ILI9488; myPinSocket_1x14
R1: 100; myResistor
R2: 10K; myResistor
R3: 220; myResistor

Connections:
unnamed: J1.1, M1.1, R1.1, R2.1
unnamed: J2.1, M1.11
unnamed: J3.1, M1.7, M1.10
unnamed: J4.1, M1.13, R3.1
unnamed: J5.1, M1.5
unnamed: J6.1, M1.3
unnamed: J7.1, M1.6, M1.12
unnamed: J8.1, M1.2
unnamed: M1.4, R2.2
unnamed: M1.8, R1.2
unnamed: M1.9, R3.2
