phorton1/Arduino-TE3/docs/kicad/led_board/led_board.kicad_pcb

## KiCad design docs/kicad/led_board/led_board.kicad_pcb (2025-03-05)

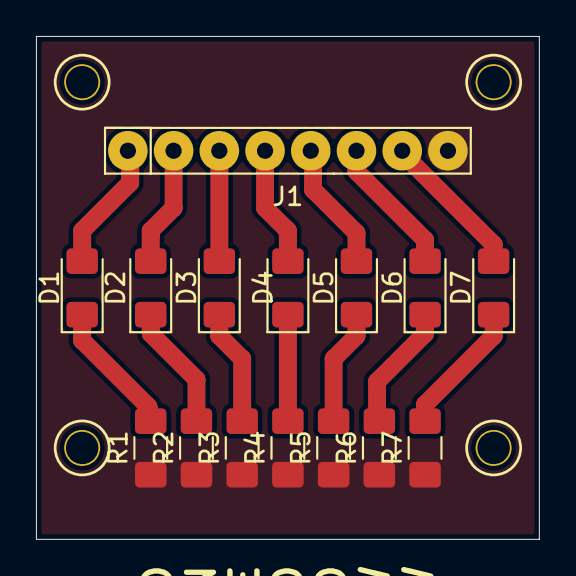
[picture p95: board led_board.kicad_pcb from above]

Board: 2 copper layers, 27.9 x 27.9 mm, 15 parts (0 on the bottom side), 15 nets.

Parts:
D1, D2, D3, D4, D5, D6, D7: LED_Small; D_1206_3216Metric_Pad1.42x1.75mm_HandSolder
J1: Conn_01x08; my8Pin
R1, R2, R3, R4, R5, R6, R7: R_Small; R_1206_3216Metric_Pad1.42x1.75mm_HandSolder

Connections:
GND: J1.8, R1.1, R2.1, R3.1, R4.1, R5.1, R6.1, R7.1
unnamed: D1.1, R1.2
unnamed: D1.2, J1.1
unnamed: D2.1, R2.2
unnamed: D2.2, J1.2
unnamed: D3.1, R3.2
unnamed: D3.2, J1.3
unnamed: D4.1, R4.2
unnamed: D4.2, J1.4
unnamed: D5.1, R5.2
unnamed: D5.2, J1.5
unnamed: D6.1, R6.2
unnamed: D6.2, J1.6
unnamed: D7.1, R7.2
unnamed: D7.2, J1.7
