phorton1/Arduino-TE3/docs/kicad/rotary_board/rotary_board.kicad_pcb

## KiCad design docs/kicad/rotary_board/rotary_board.kicad_pcb (2025-03-05)

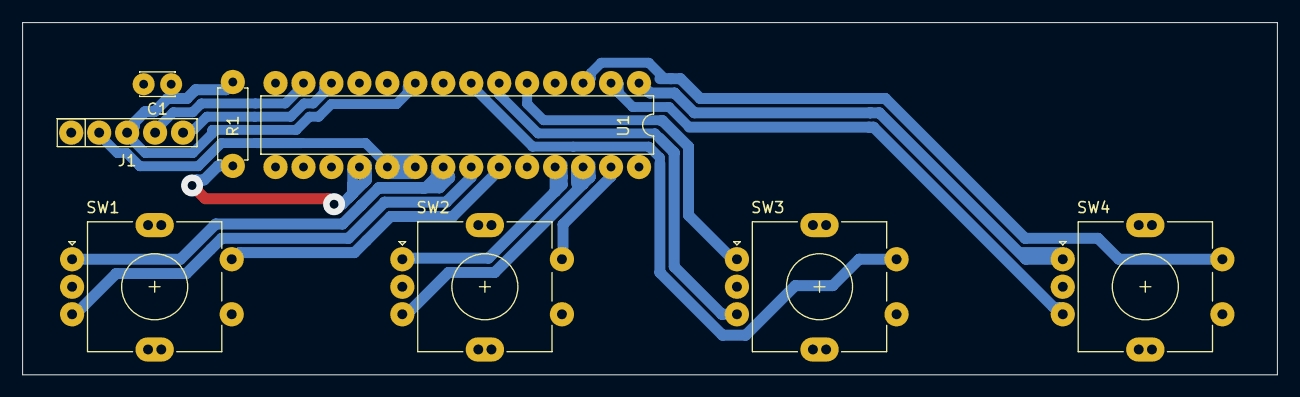
[picture p96: board rotary_board.kicad_pcb from above]

Board: 2 copper layers, 114.0 x 32.0 mm, 8 parts (0 on the bottom side), 18 nets.

Parts:
C1: 100nf; myCapCeramicSmall
J1: Conn_01x05; my5Pin
R1: 10K; myResistor
SW1: ROT1; myRotaryEncoder
SW2: ROT2; myRotaryEncoder
SW3: ROT3; myRotaryEncoder
SW4: ROT4; myRotaryEncoder
U1: mcp23017; myDip28

Connections:
+3V3: C1.1, J1.3, R1.1, U1.9
GND: C1.2, J1.1, SW1.C, SW1.S2, SW2.C, SW2.S2, SW3.C, SW3.S2, SW4.C, SW4.S2, U1.4, U1.8, U1.10, U1.11, U1.14, U1.15, U1.16, U1.17, U1.24, U1.28
unnamed: R1.2, U1.18
ROT0A: SW1.A, U1.21
ROT0B: SW1.B, U1.22
ROT1A: SW2.A, U1.25
ROT1B: SW2.B, U1.26
ROT2A: SW3.A, U1.5
ROT2B: SW3.B, U1.6
ROT3A: SW4.A, U1.1
ROT3B: SW4.B, U1.2
ROT_INT: J1.2, U1.19, U1.20
SCL: J1.5, U1.12
SDA: J1.4, U1.13
SW0: SW1.S1, U1.23
SW1: SW2.S1, U1.27
SW2: SW3.S1, U1.7
SW3: SW4.S1, U1.3
