phorton1/Arduino-TE3/docs/kicad/row_board/row_board.kicad_pcb

## KiCad design docs/kicad/row_board/row_board.kicad_pcb (2025-02-25)

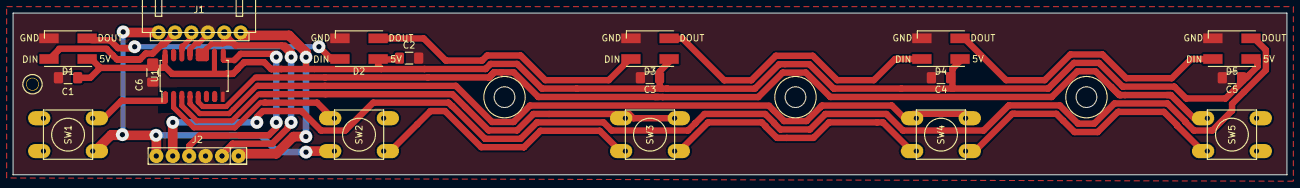
[picture p97: board row_board.kicad_pcb from above]

Board: 2 copper layers, 197.0 x 25.0 mm, 19 parts (0 on the bottom side), 17 nets.

Parts:
C1, C2, C3, C4, C5: 100nf; C_1206_3216Metric_Pad1.42x1.75mm_HandSolder
C6: 10uf; C_1206_3216Metric_Pad1.42x1.75mm_HandSolder
D1, D2, D3, D4, D5: WS2812B; myWS2812
J1: Conn_01x06; invRightAngleJSTx06
J2: Conn_01x06; my6Pin-08mm
SW1, SW2, SW3, SW4, SW5: SW1; mySwitchSoft
U1: 74HC595; SOIC-16_4.55x10.3mm_P1.27mm

Connections:
+5V: C1.1, C2.1, C3.1, C4.1, C5.1, C6.1, D1.1, D2.1, D3.1, D4.1, D5.1, J1.6, J2.1, U1.10, U1.16
BTN_CLK: J1.5, J2.2, U1.11, U1.12
BTN_DIN: J1.3, U1.14
BTN_DOUT: J2.4, U1.9
BTN_SENSE: J1.1, J2.6, SW1.2, SW2.2, SW3.2, SW4.2, SW5.2
GND: C1.2, C2.2, C3.2, C4.2, C5.2, C6.2, D1.3, D2.3, D3.3, D4.3, D5.3, J1.4, J2.3, U1.8, U1.13
LED_DIN: D1.4, J1.2
LED_DOUT: D5.2, J2.5
unnamed: D1.2, D2.4
unnamed: D2.2, D3.4
unnamed: D3.2, D4.4
unnamed: D4.2, D5.4
unnamed: SW1.1, U1.1
unnamed: SW2.1, U1.2
unnamed: SW3.1, U1.3
unnamed: SW4.1, U1.4
unnamed: SW5.1, U1.5
