phorton1/Arduino-TE3/src/winFtpSensitivity.cpp

#include <myDebug.h>
#include "winFtpSensitivity.h"
#include "defines.h"
#include "te3_tft.h"
#include "te3_leds.h"
#include "buttons.h"
#include "ftp.h"
#include "ftp_defs.h"
#include "midiHost.h"
#include "winFtpTuner.h"
#include "midiQueue.h"


#define KEYPAD_UP      7
#define KEYPAD_DOWN    17
#define KEYPAD_LEFT    11
#define KEYPAD_RIGHT   13
#define KEYPAD_SELECT  12

#define BUTTON_END_MODAL_WINDOW 24


#define ITEM_DYNAMIC_RANGE     6
#define ITEM_DYNAMIC_OFFSET    7
#define ITEM_TOUCH_SENSITIVITY 8



//------------------------------------------------------------
// life cycle
//------------------------------------------------------------

winFtpSensitivity::winFtpSensitivity(bool swap_modal)
	: expWindow(WIN_FLAG_DELETE_ON_END)
{
	init();
	m_swap_modal = swap_modal;
}


void winFtpSensitivity::init()
{
	draw_needed = 1;
	for (int i=0; i<NUM_FTP_STRINGS; i++)
	{
		last_vel[i] = 0;
		last_velocity[i] = 0;
	}
	for (int i=0; i<NUM_SENSITIVITY_ITEMS; i++)
		last_value[i] = 0;

	selected_item = 0;
	last_selected_item = 0;
}




// virtual
void winFtpSensitivity::begin(bool warm)
{
	init();
	expWindow::begin(warm);

	theButtons.setButtonType(KEYPAD_UP,   	BUTTON_TYPE_CLICK);
	theButtons.setButtonType(KEYPAD_DOWN,	BUTTON_TYPE_CLICK);
	theButtons.setButtonType(KEYPAD_LEFT,	BUTTON_TYPE_CLICK);
	theButtons.setButtonType(KEYPAD_RIGHT,	BUTTON_TYPE_CLICK);
	theButtons.setButtonType(KEYPAD_SELECT,	BUTTON_TYPE_CLICK, 	LED_GREEN);

	if (m_swap_modal)
	{
		theButtons.setButtonType(THE_SYSTEM_BUTTON, BUTTON_TYPE_CLICK,	LED_PURPLE);
		theButtons.setButtonType(BUTTON_END_MODAL_WINDOW, BUTTON_TYPE_CLICK, LED_GREEN);
	}
	else
	{
		theButtons.setButtonType(THE_SYSTEM_BUTTON,BUTTON_EVENT_CLICK,LED_GREEN);
	}

	showLEDs();
}


//------------------------------------------------------------
// events
//------------------------------------------------------------


// virtual
void winFtpSensitivity::onButtonEvent(int row, int col, int event)
{
	int num = row * NUM_BUTTON_COLS + col;

	if (num == KEYPAD_UP || num == KEYPAD_DOWN)
	{
		selected_item += (num == KEYPAD_DOWN)? 1 : -1;
		if (selected_item < 0) selected_item = NUM_SENSITIVITY_ITEMS-1;
		if (selected_item >= NUM_SENSITIVITY_ITEMS) selected_item = 0;
	}
	else if (num == KEYPAD_LEFT || num == KEYPAD_RIGHT)
	{
		if (selected_item == ITEM_DYNAMIC_RANGE)
		{
			int value = ftp_dynamic_range;
			value += (num == KEYPAD_RIGHT) ? 1 : -1;
			if (value < 10) value = 10;
			if (value > 20) value = 20;
			sendFTPCommandAndValue(FTP_CMD_SPLIT_NUMBER,0x01);
			sendFTPCommandAndValue(FTP_CMD_DYNAMICS_SENSITIVITY,value);
		}
		else if (selected_item == ITEM_DYNAMIC_OFFSET)
		{
			int value = ftp_dynamic_offset;
			value += (num == KEYPAD_RIGHT) ? 1 : -1;
			if (value < 0)  value = 0;
			if (value > 20) value = 20;
			sendFTPCommandAndValue(FTP_CMD_SPLIT_NUMBER,0x01);
			sendFTPCommandAndValue(FTP_CMD_DYNAMICS_OFFSET,value);
		}
		else if (selected_item == ITEM_TOUCH_SENSITIVITY)
		{
			int value = ftp_touch_sensitivity;
			value += (num == KEYPAD_RIGHT) ? 1 : -1;
			if (value < 0) value = 0;
			if (value > 9) value = 9;
			sendFTPCommandAndValue(FTP_CMD_TOUCH_SENSITIVITY,value);
		}
		else
		{
			int value = ftp_sensitivity[selected_item];
			if (value != -1)
			{
				value += (num == KEYPAD_RIGHT) ? 1 : -1;
				if (value < 0)  value = 0;
				if (value > 15) value = 15;
				sendFTPCommandAndValue(FTP_CMD_SET_SENSITIVITY,selected_item<<4 | value);
			}
		}
	}
	else if (num == KEYPAD_SELECT ||
			 num == BUTTON_END_MODAL_WINDOW)
	{
		endModal(0);
	}
	else if (num == THE_SYSTEM_BUTTON)
	{
		if (m_swap_modal)
			theSystem.swapModal(new winFtpTuner(true),0);
		else
			endModal(0);

	}
}



//------------------------------------------------------------
// updateUI (draw)
//------------------------------------------------------------


void winFtpSensitivity::vel2ToInts(int *vel, int *velocity)
	// move the vel2 and velocity values from notes to local variable
	// and only change vel by 1 in the process
{
	for (int i=0; i<NUM_FTP_STRINGS; i++)
	{
		vel[i] = 0;		// zero indicator
		velocity[i] = 0;	// on or off
	}

	__disable_irq();
	note_t *note = ftp_first_note;
	while (note)
	{
		int i = note->string;
		int v = note->vel2;				// compressed velocity
		velocity[i] = note->vel;		// full velocity
		vel[i] = v;
		note = note->next;
	}
	__enable_irq();

}



#define SENS_TOP     			50
#define SENS_LEFT    			80
#define SENS_DIVS       		(2 * 15)
#define SENS_BOX_WIDTH  		9
#define SENS_BOX_X_OFFSET 		10		// one blank col of pixels between
#define SENS_BOX_HEIGHT         31		// two blank rows of pixels between
#define SENS_ROW_Y_OFFSET       34

#define SENS_START_GREEN        7
#define SENS_START_RED			(30-6)

#define SENS_HEIGHT				(SENS_ROW_Y_OFFSET * 6)
#define SENS_WIDTH				(SENS_BOX_X_OFFSET * SENS_DIVS)
#define SENS_BOTTOM  			(SENS_TOP  + SENS_HEIGHT - 1)
#define SENS_RIGHT   			(SENS_LEFT + SENS_WIDTH - 1)

#define SENS_COLOR_RED          TFT_RGB_COLOR(0xff,0,0)
#define SENS_COLOR_GREEN        TFT_RGB_COLOR(0,0xff,0)
#define SENS_COLOR_YELLOW       TFT_RGB_COLOR(0xff,0xff,0)
#define SENS_COLOR_DARK_RED     TFT_RGB_COLOR(0x40,0,0)
#define SENS_COLOR_DARK_GREEN   TFT_RGB_COLOR(0,0x40,0)
#define SENS_COLOR_DARK_YELLOW  TFT_RGB_COLOR(0x40,0x40,0)

#define SENS_MIDI_VEL_WIDTH     4
#define SENS_COLOR_MIDI_VEL     TFT_RGB_COLOR(0xff,0xff,0xff)

#define NUMBER_X  				(SENS_RIGHT + 10)
#define NUMBER_WIDTH  			40


void winFtpSensitivity::drawBox(int string, int box32, int vel16)
{
	bool on = (box32/2) < vel16;
	int color =
		box32 >= SENS_START_RED ?
			(on ? SENS_COLOR_RED : SENS_COLOR_DARK_RED) :
		box32 >= SENS_START_GREEN ?
			(on ? SENS_COLOR_GREEN : SENS_COLOR_DARK_GREEN) :
			(on ? SENS_COLOR_YELLOW : SENS_COLOR_DARK_YELLOW);
	tft.fillRect(
		SENS_LEFT + box32 * SENS_BOX_X_OFFSET,
		SENS_TOP + string * SENS_ROW_Y_OFFSET,
		SENS_BOX_WIDTH,
		SENS_BOX_HEIGHT,
		color);
}



// virtual
void winFtpSensitivity::updateUI()	// draw
{
	bool full_draw = draw_needed;
	draw_needed = 0;

	int vel[6];
	int velocity[6];
	vel2ToInts(vel,velocity);
	for (int i=0; i<6; i++)
	{
		if (full_draw || last_vel[i] != vel[i])
		{
			if (last_velocity[i] && last_velocity[i] != velocity[i])
			{
				float pct = ((float)last_velocity[i]) / 127.0;
				int x = (((float)SENS_WIDTH-SENS_MIDI_VEL_WIDTH) * pct);
				tft.fillRect(
					SENS_LEFT + x,
					SENS_TOP + i * SENS_ROW_Y_OFFSET - 1, // one pixel above
					SENS_MIDI_VEL_WIDTH,
					SENS_BOX_HEIGHT+2,					  // one pixel below
					0);
			}
			last_velocity[i] = velocity[i];

			last_vel[i] = vel[i];
			for (int j=0; j<SENS_DIVS; j++)
				drawBox(i,j,vel[i]);

			if (velocity[i])
			{
				float pct = ((float)velocity[i]) / 127.0;
				int x = (((float)SENS_WIDTH-SENS_MIDI_VEL_WIDTH) * pct);
				tft.fillRect(
					SENS_LEFT + x,
					SENS_TOP + i * SENS_ROW_Y_OFFSET - 1, // one pixel above
					SENS_MIDI_VEL_WIDTH,
					SENS_BOX_HEIGHT+2,					  // one pixel below
					SENS_COLOR_MIDI_VEL);
			}
		}
	}

	if (full_draw)
	{
		tft.setFont(Arial_16);
        tft.setTextColor(TFT_YELLOW);
	    tft.setCursor(SENS_LEFT + 190,SENS_BOTTOM + 8);
		tft.print("Dyn Range");
	    tft.setCursor(SENS_LEFT + 190,SENS_BOTTOM + 3 + SENS_ROW_Y_OFFSET);
		tft.print("Dyn Offset");

	    tft.setCursor(SENS_LEFT,SENS_BOTTOM + 8);
		tft.print("Touch Sens");
	}

	bool selection_changed = last_selected_item != selected_item;

	for (int i=0; i<NUM_SENSITIVITY_ITEMS; i++)
	{
		int value =
			i == ITEM_DYNAMIC_RANGE ? ftp_dynamic_range :
			i == ITEM_DYNAMIC_OFFSET ? ftp_dynamic_offset :
			i == ITEM_TOUCH_SENSITIVITY ? ftp_touch_sensitivity :
			ftp_sensitivity[i] + 1;


        if (full_draw ||
			last_value[i] != value ||
			(selection_changed && (
				selected_item == i ||
				last_selected_item == i	)))
		{
			last_value[i] = value;
			int color = i == selected_item ? TFT_BLUE : 0;

			int x = i >= ITEM_TOUCH_SENSITIVITY ?
				SENS_LEFT + 120 :
				NUMBER_X;
			int y = i >= ITEM_TOUCH_SENSITIVITY ?
				SENS_TOP + (i-2) * SENS_ROW_Y_OFFSET - 3 :
				SENS_TOP + i * SENS_ROW_Y_OFFSET - 3;

			tft.setFont(Arial_16_Bold);
			tft.fillRect(
				x,
				y,
				NUMBER_WIDTH,
				SENS_BOX_HEIGHT,
				color);
			tft.printfJustified(
				x + 5,
				y + 7,
				NUMBER_WIDTH-10,
				SENS_BOX_HEIGHT-6,
				LCD_JUST_RIGHT,
				TFT_WHITE,
				color,
				false,
				"%-2d",
				last_value[i]);
		}
	}

	last_selected_item = selected_item;
}
