phorton1/Arduino-TE3/(commit log)

2024-05-11 iniitial TE3.ino and rotaryBoard.h & cpp & schematic tested as prototype
    [rotary_board.kicad_pcb, rotary_board.sch]
2024-05-11 added .gitignore to all TE related doc/kicad folders. Renamed and moved kicad designs around. See /junk/maybe_save for remnants
    [_prototype0.kicad_pcb, _prototype0.sch, _prototype1.kicad_pcb, _prototype1.sch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]
2024-05-12 updated kicad .gitignore's
    [rpi_connector.kicad_pcb]
2024-05-13 update all TE preferences.txt to build in /src/ArduinoBuilds for easier clean builds
2024-05-13 added ESP32 initial version of WITH_HUB_SERIAL and esp32_breadboard kicad stuff
    [esp32_board.kicad_pcb, esp32_board.sch]
2024-05-15 added Arduino-libraries-TE3_common repo, starting with (renamed) teSGTL5000.h and cpp
2024-05-19 cleanup; breakout serial.h and cpp, write testSerialImplementation that lets me telnet to ESP32 to control the teensy SGTL5000
2024-05-21 After first tests with iPad USB - reworked TE3_hub audio setup; reworked SGTL5000 setDefaults() and some method semantics; moved sgtl5000 implementation to TE3_hub; made sgtl5000midi.h and teCommon.h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
    [serial.cpp]
2024-05-28 pushing intermediate and messy TE3 vGuitar system kicad designs
    [rpiSGTL5000.kicad_pcb, rpiSGTL5000.sch]
2025-01-22 restart TE3 project - BEFORE CHANGING TE3 TO TEENSY 4.1 - LAST ESP32 TE3 version
2025-01-23 INITIAL COMMIT OF "REAL" TEENSY 4.1 based TE3
2025-01-23 got rid of (many) vestigial TE3 design attempts; consolidating electronics under TE3/docs/kicad
    [esp32_board.kicad_pcb, esp32_board.sch, lcd_connector.kicad_pcb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]
2025-01-24 added kicad lcd_connector to TE3 repo
    [lcd_connector.kicad_pcb, lcd_connector.sch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]
2025-01-24 initial kicad design of TE3 mother_board
    [mother_board.kicad_pcb, mother_board.sch, row_board.sch]
2025-01-25 tested prototype rotary board
    [mother_board.sch, rotary_board.sch]
2025-01-27 built row_board_prototype pcb; added te3_leds (with BC547 level up shifter) and prep for te3_buttons (with 74HC595 polling)
    [mother_board.sch, row_board.kicad_pcb, row_board.sch, row_board.step, test-F_Paste.dxf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]
2025-01-30 implemented & tested 2nd row_board prototype 595 buttons; switch to 3.3V row_boards; got rid of 1st row board prototype kicad; ready to start designing motherboard
    [mother_board.sch, row_board.kicad_pcb, row_board.sch, row_board.step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]
2025-01-30 mother_board schematic comments only
    [mother_board.sch]
2025-01-31 update teensy Arduino preferences.txt to work on USBC hub
2025-02-02 add BUSY (as well as current ALIVE) LEDa
2025-02-02 continuing work on TE3 kicad designs
    [lcd_connector.kicad_pcb, lcd_connector.sch, lcd_connector.step, mother_board - Copy.kicad_pcb, mother_board.kicad_pcb, mother_board.sch]
2025-02-06 added some test code to send out a midi message (guitar distortion on/off) within the prototype/breadboard system
2025-02-06 FINALLY landed on the store bought USBC hub solution. It works in any cable orientation and charges the iPad at 15V/25W while also working with USB midi, and presumably audio, data. - remove glue and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
2025-02-06 YAY! Ready to start designing actual mother_board and USBC_connector boards, to move on to 3D printing stuff
    [mother_board - Copy.kicad_pcb, mother_board.kicad_pcb, mother_board.sch]
2025-02-07 design TE3 motherboard
    [mother_board.kicad_pcb, mother_board.sch]
2025-02-07 mod TE3 pins accoring to mother_board design (reworked breadboard)
    [defines.h]
2025-02-09 new row board design (with chip at left end)
    [row_board.kicad_pcb, row_board.sch, row_board.step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]
2025-02-09 messing with kicad and flatcam - gonna upgrade to kicad 8
    [test_mother_board.kicad_pcb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]
2025-02-11 kicad changes to support actual Fusion 360 TE3 design efforts - created rotary board PCB
    [mother_board.kicad_pcb, mother_board.sch, rotary_board.kicad_pcb, rotary_board.sch, row_board.kicad_pcb, row_board.sch, row_board.step]
2025-02-14 added kicad led_board, updated mother board RCA socket
    [led_board.kicad_pcb, led_board.sch, led_board.step, mother_board.kicad_pcb, rotary_board.kicad_pcb]
2025-02-25 printed first 3D parts for TE3
    [button_base_left.stl, button_base_right.stl, row_base.stl, row_button.stl, row_cover.stl]
2025-02-25 cutting actual TE3 milled circuit boards
    [button_base_left.3mf, button_base_right.3mf, mother_board.kicad_pcb, mother_board.sch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]
2025-02-27 3D print most of TE3
    [back_fastener.stl, bezel.stl, hub_holder.stl, slider_bottom.3mf, slider_bottom.stl, slider_top.3mf, slider_top.stl, small_parts.3mf]
2025-02-27 PCB milling marathon - made 5 row_boards, rotary_board, led_board, and reworked detailed design of motherboard - motherboard *should* match old one that was milled and installed in initial TE3 box
    [led_board.kicad_pcb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]
2025-03-05 got rid of obsolete old mother_board and row_board kicad files
    [mother_board.kicad_pcb, mother_board.sch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]
2025-03-05 added TE3 milled USBA connector with 3D printed case
    [usb_connector_bottom.stl, usb_connector_calcs.xlsx, usb_connector_top.stl, usb_connector_x3.3mf, usba_connector.kicad_pcb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]
2025-03-05 added TE3 lcd_connector kicad_pcb, though I'm using ones milled a long time ago for cnc20mm
    [lcd_connector.kicad_pcb]
2025-03-05 final inital TE3 3D printing
    [bezel.3mf, row_button_x25_PLA.3mf]
2025-03-05 final initial TE3 PCBS - updated LED board green resistor to 1K - changed TE3 display SCLK to pin13 as it is required for hardware SPI0 - changed nomenclature of rotary board to ROT0..ROT4 and correc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
    [led_board-F_Paste.dxf, led_board.kicad_pcb, mother_board.kicad_pcb, mother_board.sch, rotary_board.kicad_pcb, rotary_board.sch, row_board-F_Paste.dxf]
2025-03-05 fixed WS2812b led ordering as they are now all left-to-right on row_boards instead of alternating left-to-right then right-to-left as in TE1/2
    [te3_leds.cpp]
2025-03-05 TE3 PCB UNIT TESTS - rotary board, and row_board testing - added raw button presses to rotaryBoard.h/cpp and fixed inverted rotary 3/4 order as per PCB - added initial crude te3_tft.h and cpp to veri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
    [TE3.ino, defines.h, rotaryBoard.cpp, rotaryBoard.h, te3_tft.cpp, te3_tft.h]
2025-03-05 START INTEGRATED TE3 mother_board testing - got the rPi display and com port basically working - discovered I had left the circle stuff in odd shape (460800 using OCTO audio device even with LOOPER3 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
    [te3_serial.cpp]
2025-03-05 Fixed problems discovered after milling 1st test mother_board. - effing had I2S BCLK and FCLK going to wrong pins on teensy4.0!! - connector for revD audio pins was off by 1.5mm - separated rPI and t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
    [mother_board.kicad_pcb, mother_board.sch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]
2025-03-05 completed first phase of mother_board testing ... - implemented rPi state LEDs - got rid of PIN_LED_TE3_ALIVE which conflicted with needed use of teensy4.1 pin13 as SCLK for display - implemented rud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
    [TE3.ino, defines.h, te3_serial.cpp]
2025-03-05 added important 220 ohm resistor with MISO going FIRST to Touch after TE3 testing
    [lcd_connector.kicad_pcb, lcd_connector.sch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]
2025-03-06 final integration test before adding audio connectors, hot gluing wires, and cutting wood base - tested with usbC hub, deleted all COM and TE3 related devices so TE3 is now COM3 and TE3_audio is COM4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
2025-03-06 check in fusion stuff and base lightburn
    [laser_cut_base.dxf, usba_connector_plastic.f3d]
2025-03-07 loosen slider tolerances and fix host usb bracket in fusion design, stl's, and prusa projects and gcode files after initial print/assembly
    [back_fastener.stl, back_fasteners.3mf, slider_bottom.3mf, slider_bottom.stl, small_parts.3mf]
2025-03-09 Iniitial BREAKTHROUGH implementation of fileSystem basics - uses fileXXXX.h and cpp common to TE1, TE2, and TE3 - TE1/2 now use official teensy SD/SdFat libraries! - so can get rid of my old denormal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
    [TE3.ino, defines.h, fileSystem.h]
2025-03-09 INITIAL crude WORKING FILE SERVER; fileXXX.h and cpp need normalization to TE1/2 - moved timer_handler() loop methods to TE3.ino loop() method - got rid of all FULL_IMPLEMENTATION 0 defines - minor f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
    [TE3.ino, defines.h, expSystem.cpp, fileSystem.h, filesSerial.cpp, songParser.cpp, te3_serial.cpp]
2025-03-09 made bug fixes to get default font to work in ILI9488_t3 for TE3
    [te3_tft.cpp, te3_tft.h]
2025-03-10 fixed multi-line printJustified calls; added DEBUG_PRINT_JUST define
    [te3_tft.cpp]
2025-03-10 added songMachine debugging and got BIG_RIVER and CHINA_CAT running correctly
    [songMachine.cpp, songMachine.h]
2025-03-10 increase ctrl-E timeout window for binary uploads over TE3 DBG_SERIAL_PORT. addl - te3_serial: don't output to mappable RPI and HUB output devices if they are zero;
2025-03-11 found, documented, and fixed test PCB problems with I2S_IXR, LINE_IN_R, GND, and LINE_OUT_R traces (bad schematic and bad kicad symbols)
    [mother_board.kicad_pcb, mother_board.sch]
2025-03-11 check in TE3, TE3_audo, circle/_prh, and _apps/Looper after initial TE3 integration success. - rotaries don't work - only very few USBC cables work on the iPad, but strangely those that do, also work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
2025-03-12 BEGIN MIDI PORT REWORK - brought midiQueue.h/cpp and ftp.h/cpp from TE2, renamed existing TE3's to avoid conflicts
    [midiQueue.cpp, midiQueue.h]
2025-03-13 REWORKED ENTIRE MIDI_PORT SCHEME - including defines, prefs, options, midiQueue, midiHost, and ftp.cpp and h - requires myDebug fixes to fix "rotaries not working or crashing" bug. - tested on desk w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
    [TE3.ino, configOptions.cpp, configOptions.h, configSystem.cpp, defines.h, expSystem.cpp, expSystem.h, ftp.cpp]
2025-03-14 Implement Looper specific CC Monitoring; TE3.ino now issues LOOP_COMMAND_GET_STATE at RPI_READY and responds to LOOP_CONTROL VOLUMES - volumes get set so that rotaries don't jump - turn off dbgSerial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
    [TE3.ino, expSystem.cpp, midiMonitor.cpp, pedals.cpp, rigLooper.cpp, te3_leds.cpp, te3_rotaries.h, te3_serial.cpp]
2025-03-15 more fruitless playing with the USBC hub cable issue
2025-03-15 fix pedal output channel
    [pedals.cpp]
2025-03-15 fix setFTPActivePort and switch from MIDI_PORT_USB1 (0x00) to MIDI_PORT_USB2 (0x01) for remote ftp
    [midiQueue.cpp]
2025-03-15 Implement te3_serial.cpp circular buffers, separating pollSerial(), called by timer_handler() from processSerial(), called by loop() - cleanup te3_sereial.cpp comments and file structure
2025-03-15 important: FIXED te3_serial.cpp "in_file_command" mode to use circular buffer methods; also: - added te3_serial.cpp initSerialBuffers() to malloc() serial buffers rather than use static allocation - 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
    [TE3.ino, defines.h, filesSerial.cpp, midiMonitor.cpp, te3_serial.cpp]
2025-03-18 minor solder.htm documentation fixes
2025-03-18 add readme.md pointing to github pages https://phorton1.github.io/Arduino-TE3/
2025-03-18 produced and submitted mother_board and row_board to PCBWay for production
    [mother_board.kicad_pcb, mother_board.sch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]
2025-03-19 updated PCBWay designs after DRC Design Rules Checks
    [mother_board_pcbway-B_Cu.gbr, mother_board_pcbway-B_Mask.gbr, mother_board_pcbway-Edge_Cuts.gbr, mother_board_pcbway-F_Cu.gbr, mother_board_pcbway-F_Fab.gbr, mother_board_pcbway-F_Mask.gbr, mother_board_pcbway-F_SilkS.gbr, mother_board_pcbway.drl]
2025-03-21 added "Next" buttons and updated styles
2025-03-22 add 3d printed button caps
    [button_cap.stl, button_cap_x_4.3mf]
2025-03-24 docs: solder.htm typos
2025-03-25 print new fan1_ring1 for stbd fan
